NedelcuBogdanSebastian/SistemAchizitie/MODULE/AQETHBluePill_w_RESET/BLUEPILL-PINOUT.PNG

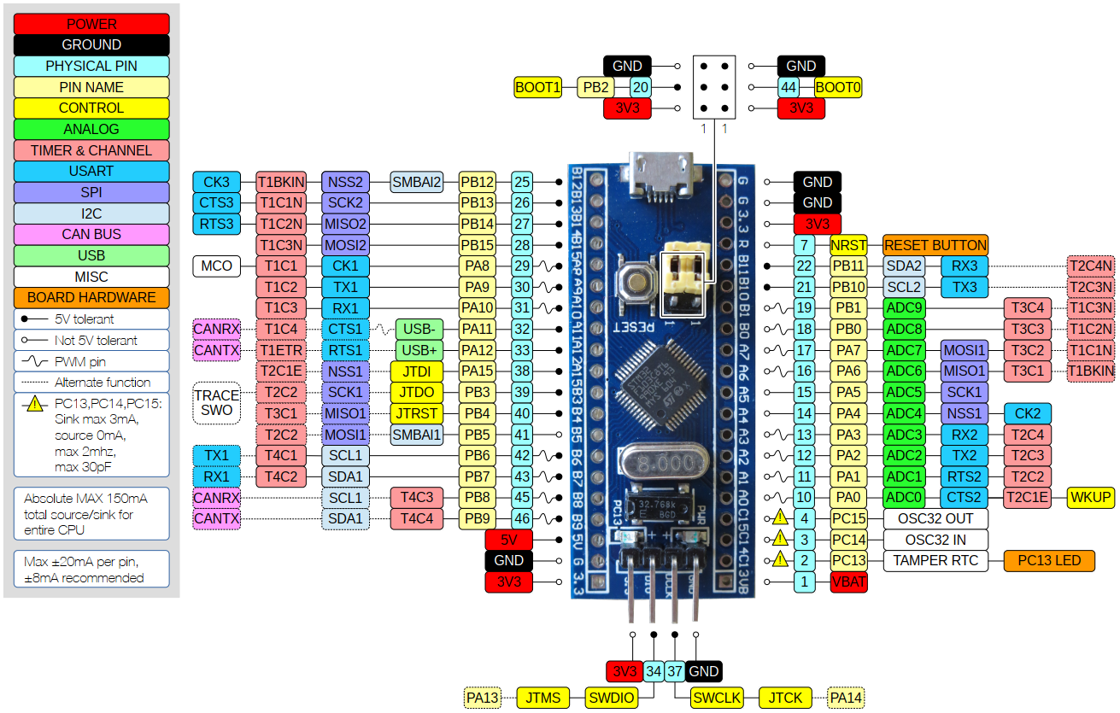
MODULE/AQETHBluePill_w_RESET/BLUEPILL-PINOUT.PNG
