NedelcuBogdanSebastian/SistemAchizitie/MODULE/PT100Module/CJMCU-MAX31865.bmp

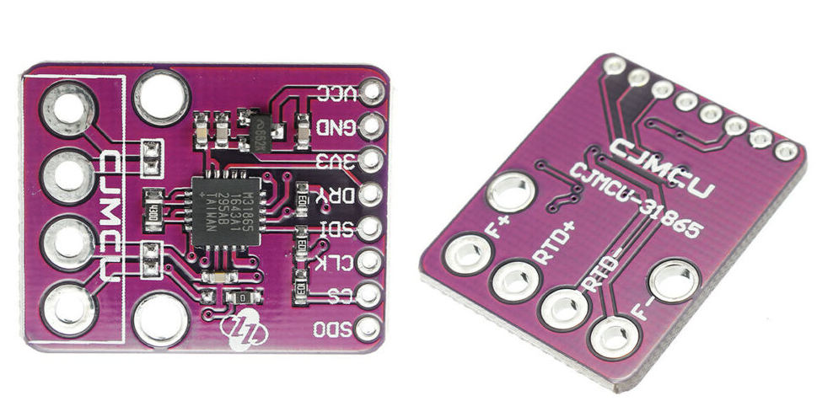
MODULE/PT100Module/CJMCU-MAX31865.bmp
