NedelcuBogdanSebastian/SistemAchizitie/MODULE/PT100Module/BOM-PCB-PT100.xlsx

 | DENUMIRE COMPONENTA | DESCRIERE COMPONENTA | COD ECAS
U3 | LM1117-MPX-3.3/NOPB | STABILIZATOR DE TENSIUNE; LDO, NEREGLABIL; 3,3V; 0,25A; SOT89-3 | MCP1703T-3302E/MB | 0.525
TERMINAL CU SURUB | 20.101M/2 | 9632670 WIRE-TO-BOARD TERMINAL BLOCK, 5 MM, 2 WAYS, 22 AWG, 12 AWG, SCREW | ARK210/2 | 0.150
LED | LED GREEN 0805 | LEN VERDE 0805 CARCASA ALBA | LTST-C170KGKT | 0.029
U4 | ATMEGA88PA-AU | AVR MICROCONTROLLER; EEPROM: 512B; SRAM: 1KB; FLASH: 8KB; TQFP32 | ATMEGA88PA-AU | 0.975
U1,U2,U5,U6 | MAX31865ATP+ | CONVERTOR DE TEMPERATURĂ; RTD; SMD; INTERFAŢĂ: SPI; TQFN20; 3,3V
C7,C9 | CL31A226MOCLNNC | CONDENSATOR: CERAMIC; 22UF; 16V; X5R; ±20%; SMD; 1206 SAMSUNG | CVUF022K12X-16 | 0.031
C1,C2,C3,C4,C5,C6,C8,C10,C11,C12,C13,C14,C15,C16 | C0805C104K5RAC | CONDENSATOR 0805, 100NF, 50V, XR7 +-10% | CVNF100K0805-100 | 0.029
R3,R4,R5,R7,R8,R9,R10 | SMD0805-10K-1% | REZISTENTA 10K
R6 | SMD0805-1K-1% | REZISTENTA 1K | CR0805K001-1 | 0.007
R1,R2,R10,R11 |  | REZISTENTA 430 OHM, 0.1%, 0805
DIO | DIODĂ: COMUTAŢIE; SMD; 100V; 200MA; 4NS; | 66 | PMLL4148L.115 | 0.015
IN DREAPTA | SOCLU; ŞIRURI PINI; MAMĂ; PIN:3; ÎN UNGHI 90°; 2,54MM; THT; 1X3 | 66 | ZL263-3SG | 0.023
IN STANGA | ŞIR PINI; ŞIRURI PINI; TATĂ; PIN:40; ÎN UNGHI 90°; 2,54MM; THT | 66 | ZL211-40KG | 0.090
