NedelcuBogdanSebastian/SistemAchizitie/MODULE/AdaptorK7EthernetTo485/AdaptorEthernet485.brd

## EAGLE design MODULE/AdaptorK7EthernetTo485/AdaptorEthernet485.brd (2024-10-08)

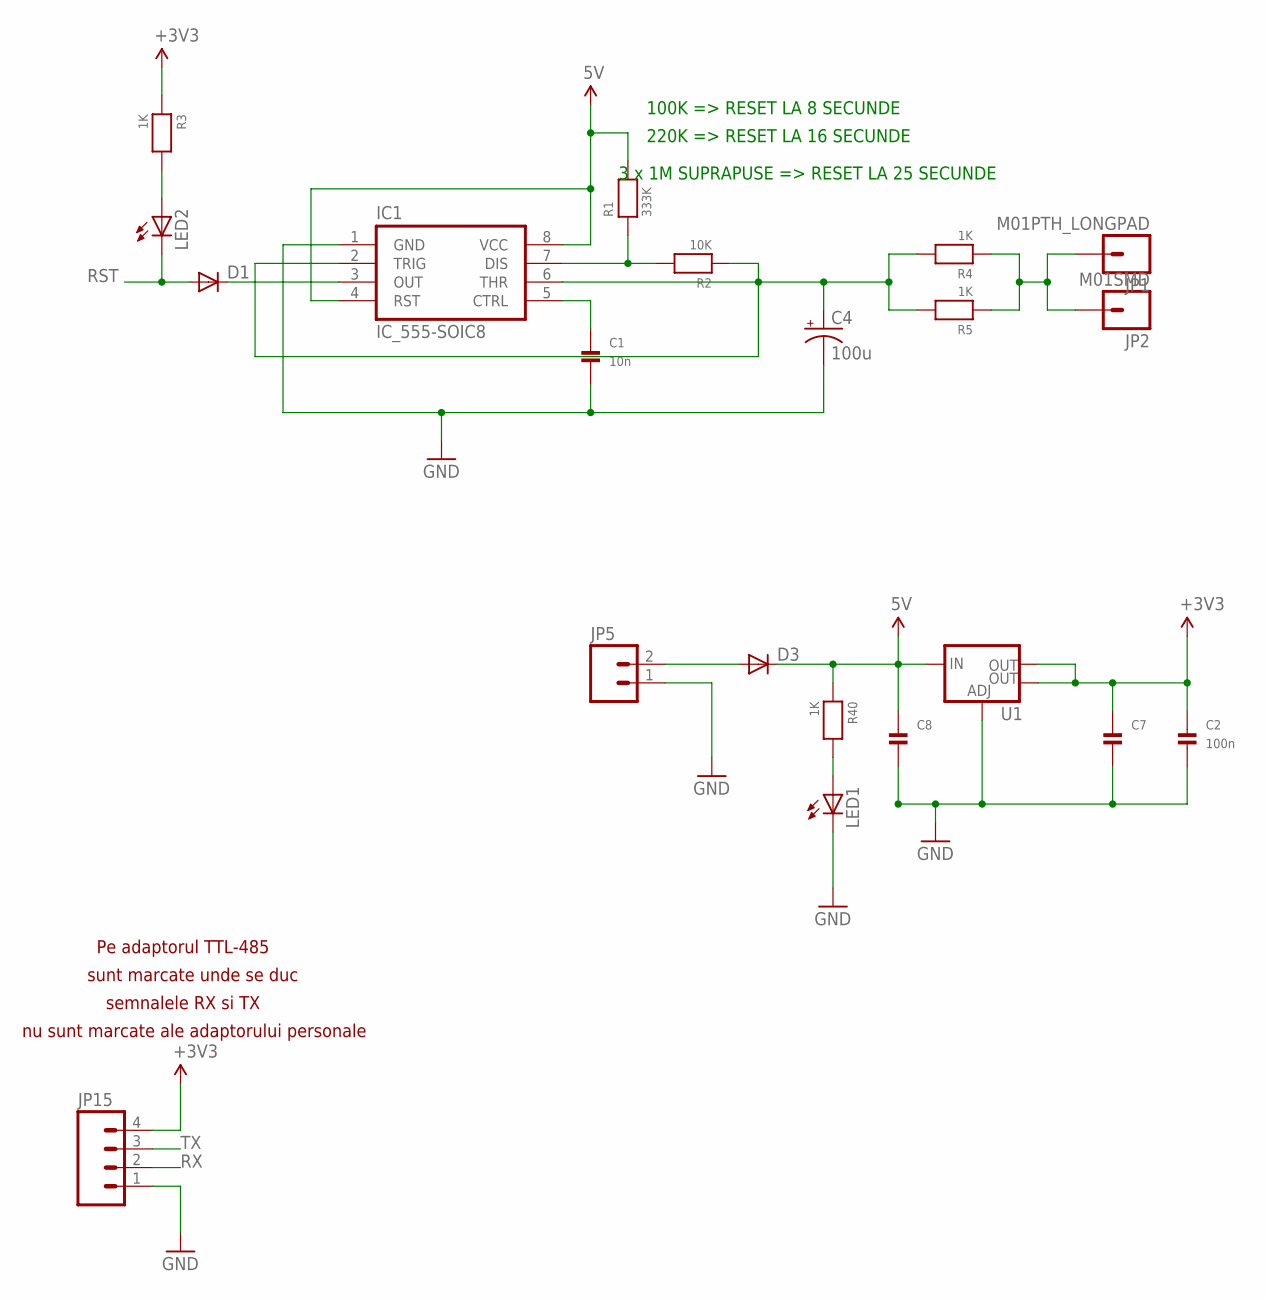
[picture p5: schematic AdaptorEthernet485.sch]

Parts:
C1: 10n; _0805MP
C2: 100n; _0805MP
C4: 100u; CPOL-RADIAL-10UF-25V
C7, C8: CAP_CERAMIC1206; 1206
D1, D3: DIODE-DO214AA; DO214AA
IC1: IC_555-SOIC8; SOIC-8
JP1: M01PTH_LONGPAD; 1X01_LONGPAD
JP2: M01SMD; LUXEON-PAD
JP5: M02PTH4; 1X02_XTRA_BIG
JP15: M04LONGPADS; 1X04_LONGPADS
LED1, LED2: LED-3MM-NO_SILK; LED3MM-NS
R1: 333K; _0805MP
R2: 10K; _0805MP
R3, R4, R5, R40: 1K; _0805MP
U1: V_REG_LM1117SOT223; SOT223

Connections:
5V: C8.1, D3.C, IC1.4 (RST), IC1.8 (VCC), R1.2, R40.1, U1.3 (IN)
CTRL: C1.1, IC1.5 (CTRL)
GND: C1.2, C2.2, C4.2 (-), C7.2, C8.2, IC1.1 (GND), JP5.1, JP15.1, LED1.K (C), U1.1 (ADJ)
unnamed: D3.A, JP5.2
unnamed: LED2.A, R3.2
unnamed: C4.1 (+), IC1.2 (TRIG), IC1.6 (THR), R2.1, R4.2, R5.2
unnamed: D1.C, IC1.3 (OUT)
unnamed: IC1.7 (DIS), R1.1, R2.2
unnamed: JP1.1, JP2.P$1, R4.1, R5.1
unnamed: LED1.A, R40.2
RST: D1.A, LED2.K (C)
RX: JP15.2
TX: JP15.3
VCC: C2.1, C7.1, JP15.4, R3.1, U1.2 (OUT), U1.4 (OUT)

Notes on the sheet:
Pe adaptorul TTL-485
sunt marcate unde se duc
semnalele RX si TX
nu sunt marcate ale adaptorului personale
3 x 1M SUPRAPUSE => RESET LA 25 SECUNDE
220K => RESET LA 16 SECUNDE
100K => RESET LA 8 SECUNDE

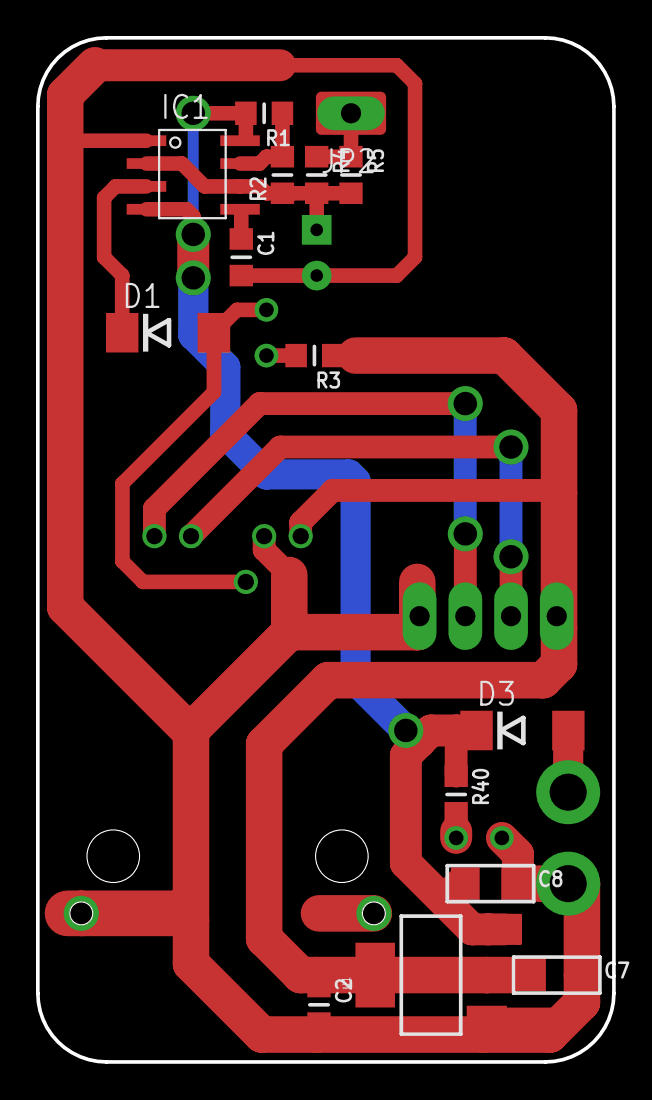
[picture p6: board AdaptorEthernet485.brd from above]

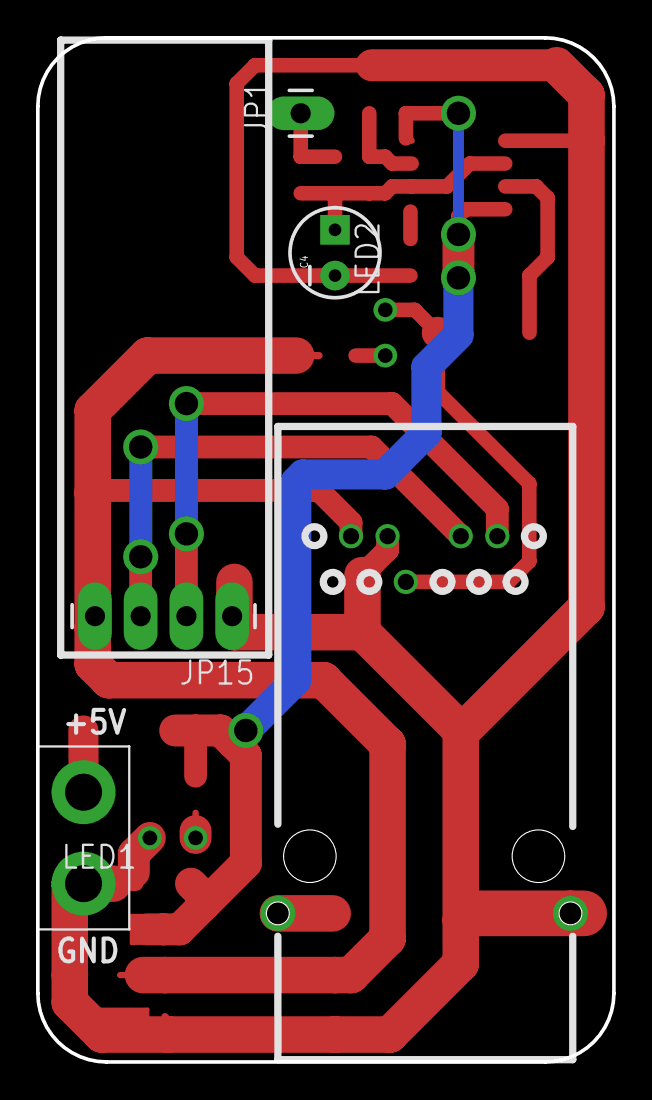
[picture p7: board AdaptorEthernet485.brd from below]

Board: 2 copper layers, 32.0 x 56.9 mm, 21 parts (6 on the bottom side), 12 nets.
