NedelcuBogdanSebastian/SistemAchizitie/MODULE/DigitalModule/DIGITAL2.brd

## EAGLE design MODULE/DigitalModule/DIGITAL2.brd (2024-10-08)

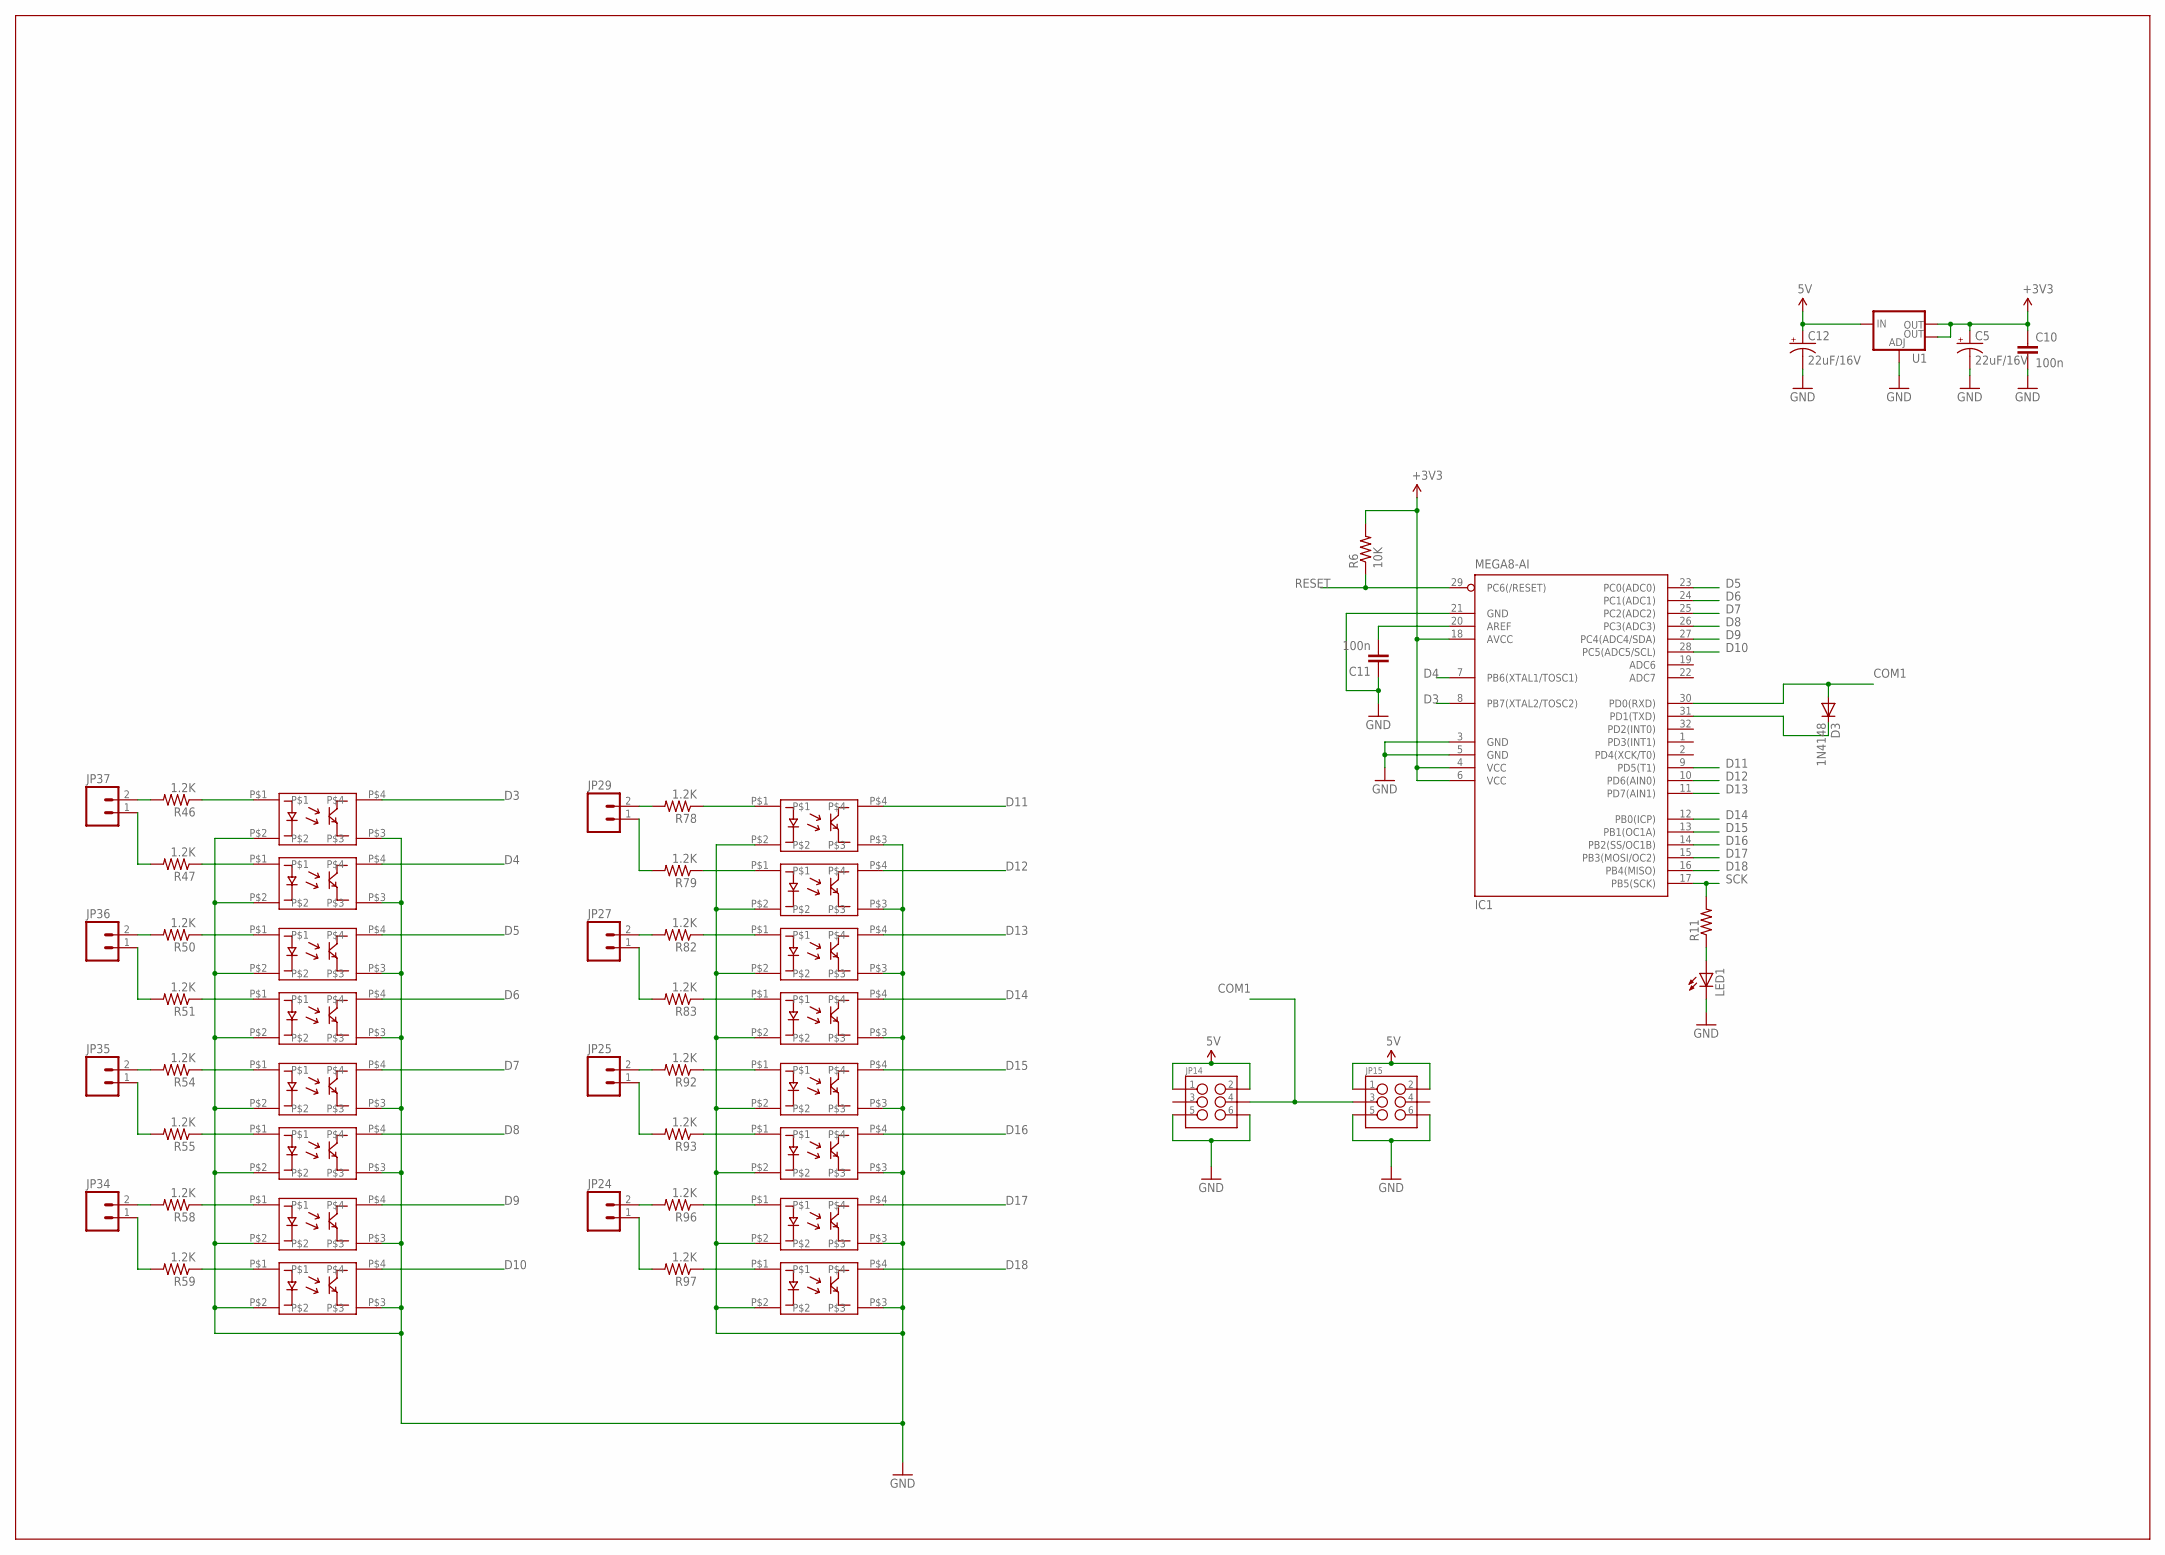
[picture p8: schematic DIGITAL2.sch]

Parts:
C5, C12: 22uF/16V; EIA3216
C10, C11: 100n; 0805
D3: 1N4148; MINIMELF
IC1: MEGA8-AI; TQFP32-08
JP14, JP15: M03X22X3_SILK_MALE_PTH; 2X3
JP24, JP25, JP27, JP29, JP34, JP35, JP36, JP37: M025MM; SCREWTERMINAL-5MM-2
LED1: LEDCHIP-LED0805; CHIP-LED0805
R6: 10K; 0805
R11: RESISTOR0805-RES; 0805
R46, R47, R50, R51, R54, R55, R58, R59, R78, R79, R82, R83, R92, R93, R96, R97: 1.2K; 1206
U1: V_REG_LM1117SOT223; SOT223
U$13, U$14, U$15, U$16, U$17, U$18, U$19, U$20, U$29, U$30, U$31, U$32, U$33, U$34, U$35, U$36: IS181D-I; TLP181-I

Connections:
5V: C12.A (+), JP14.1, JP14.2, JP15.1, JP15.2, U1.3 (IN)
COM1: D3.A, IC1.30 (PD0(RXD)), JP14.4, JP15.3
D3: IC1.8 (PB7(XTAL2/TOSC2)), U$13.P$4
D4: IC1.7 (PB6(XTAL1/TOSC1)), U$14.P$4
D5: IC1.23 (PC0(ADC0)), U$15.P$4
D6: IC1.24 (PC1(ADC1)), U$16.P$4
D7: IC1.25 (PC2(ADC2)), U$17.P$4
D8: IC1.26 (PC3(ADC3)), U$18.P$4
D9: IC1.27 (PC4(ADC4/SDA)), U$19.P$4
D10: IC1.28 (PC5(ADC5/SCL)), U$20.P$4
D11: IC1.9 (PD5(T1)), U$29.P$4
D12: IC1.10 (PD6(AIN0)), U$30.P$4
D13: IC1.11 (PD7(AIN1)), U$31.P$4
D14: IC1.12 (PB0(ICP)), U$32.P$4
D15: IC1.13 (PB1(OC1A)), U$33.P$4
D16: IC1.14 (PB2(SS/OC1B)), U$34.P$4
D17: IC1.15 (PB3(MOSI/OC2)), U$35.P$4
D18: IC1.16 (PB4(MISO)), U$36.P$4
GND: C5.C (-), C10.2, C11.1, C12.C (-), IC1.3 (GND), IC1.5 (GND), IC1.21 (GND), JP14.5, JP14.6, JP15.5, JP15.6, LED1.C, U1.1 (ADJ), U$13.P$2, U$13.P$3, U$14.P$2, U$14.P$3, U$15.P$2, U$15.P$3, U$16.P$2, U$16.P$3, U$17.P$2, U$17.P$3, U$18.P$2, U$18.P$3, U$19.P$2, U$19.P$3, U$20.P$2, U$20.P$3, U$29.P$2, U$29.P$3, U$30.P$2, U$30.P$3, U$31.P$2, U$31.P$3, U$32.P$2, U$32.P$3, U$33.P$2, U$33.P$3, U$34.P$2, U$34.P$3, U$35.P$2, U$35.P$3, U$36.P$2, U$36.P$3
unnamed: LED1.A, R11.1
unnamed: D3.C, IC1.31 (PD1(TXD))
unnamed: JP29.2, R78.2
unnamed: C11.2, IC1.20 (AREF)
unnamed: JP27.2, R82.2
unnamed: JP25.2, R92.2
unnamed: JP24.2, R96.2
unnamed: JP27.1, R83.2
unnamed: JP25.1, R93.2
unnamed: JP24.1, R97.2
unnamed: JP37.2, R46.2
unnamed: JP37.1, R47.2
unnamed: R46.1, U$13.P$1
unnamed: R47.1, U$14.P$1
unnamed: JP36.2, R50.2
unnamed: JP36.1, R51.2
unnamed: R50.1, U$15.P$1
unnamed: R51.1, U$16.P$1
unnamed: JP35.2, R54.2
unnamed: JP35.1, R55.2
unnamed: R54.1, U$17.P$1
unnamed: R55.1, U$18.P$1
unnamed: JP34.2, R58.2
unnamed: JP34.1, R59.2
unnamed: R58.1, U$19.P$1
unnamed: R59.1, U$20.P$1
unnamed: JP29.1, R79.2
unnamed: R78.1, U$29.P$1
unnamed: R79.1, U$30.P$1
unnamed: R82.1, U$31.P$1
unnamed: R83.1, U$32.P$1
unnamed: R92.1, U$33.P$1
unnamed: R93.1, U$34.P$1
unnamed: R96.1, U$35.P$1
unnamed: R97.1, U$36.P$1
RESET: IC1.29 (PC6(/RESET)), R6.1
SCK: IC1.17 (PB5(SCK)), R11.2
VCC: C5.A (+), C10.1, IC1.4 (VCC), IC1.6 (VCC), IC1.18 (AVCC), R6.2, U1.2 (OUT), U1.4 (OUT)

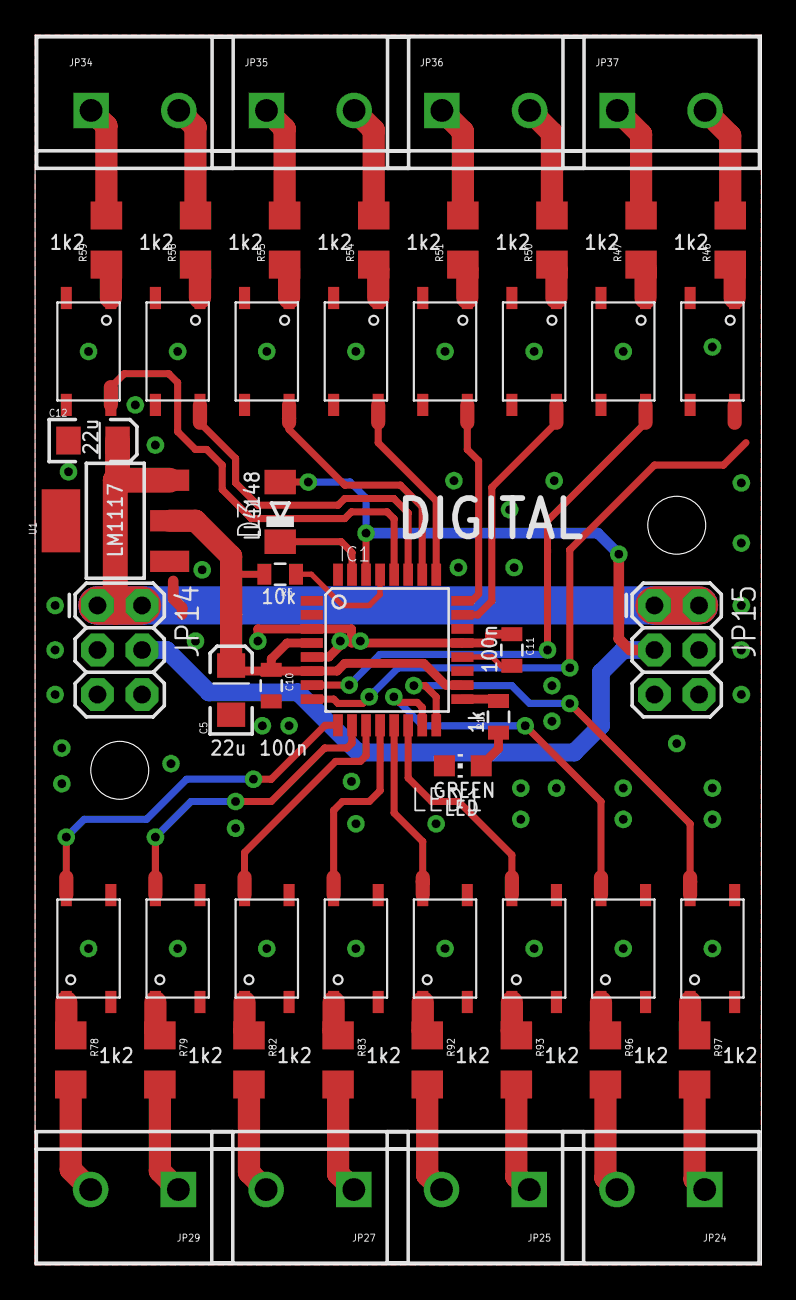
[picture p9: board DIGITAL2.brd from above]

Board: 2 copper layers, 41.4 x 70.1 mm, 54 parts (0 on the bottom side), 57 nets.

Other parts of the board:
STANDOFF1, STANDOFF3: STAND-OFF
