NedelcuBogdanSebastian/SistemAchizitie/MODULE/PT100Module/PT100RTD.brd

## EAGLE design MODULE/PT100Module/PT100RTD.brd (2024-10-08)

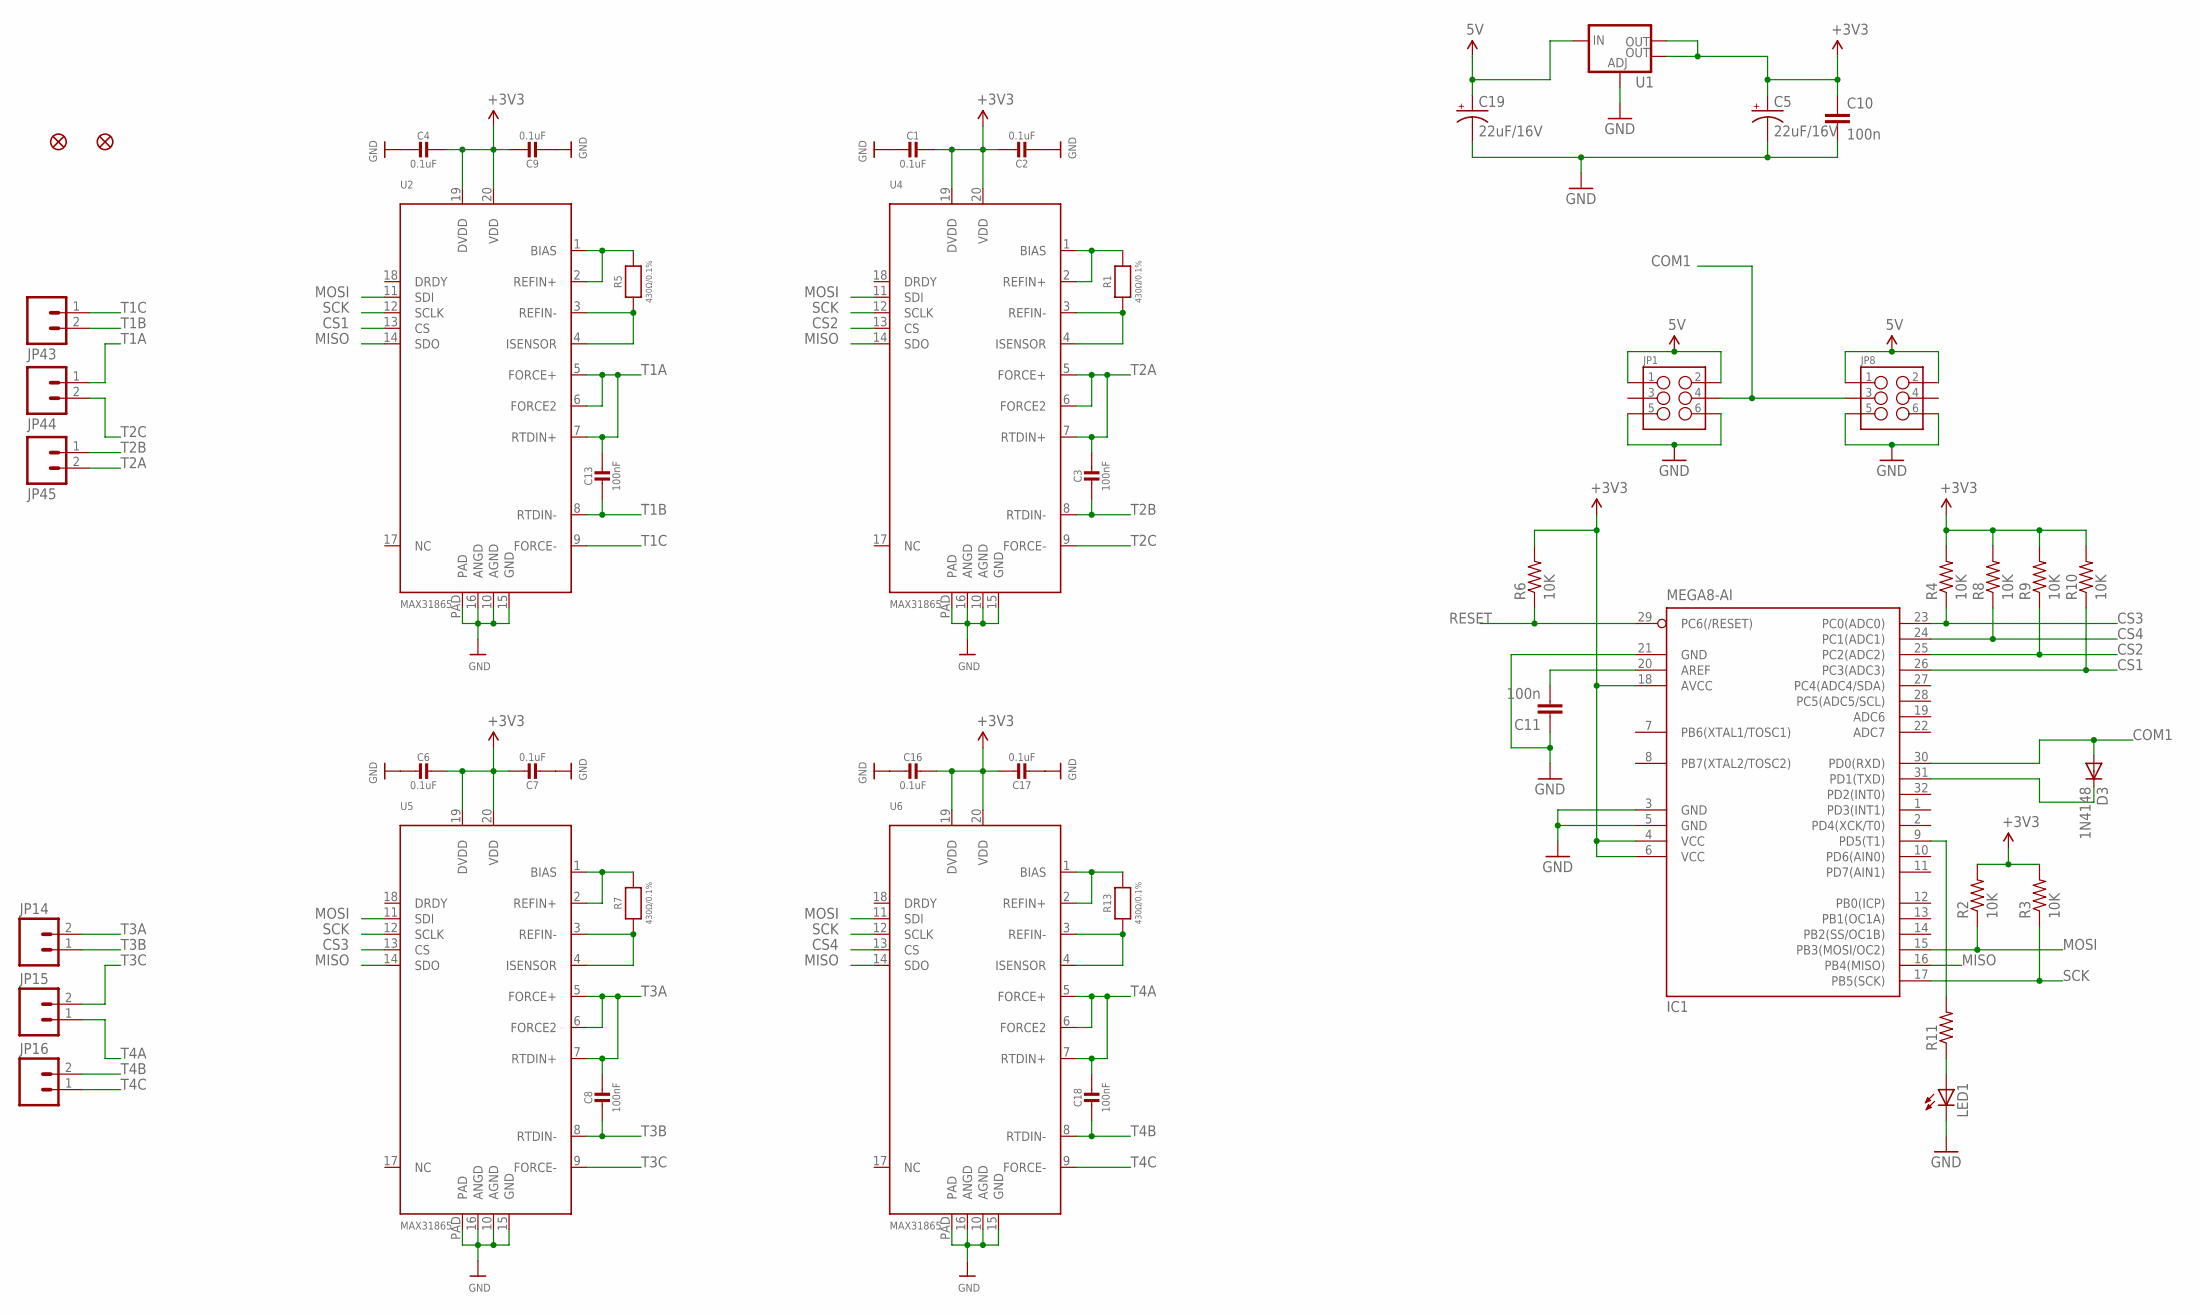
[picture p10: schematic PT100RTD.sch]

Parts:
C1, C2, C4, C6, C7, C9, C16, C17: 0.1uF; 0805-NO
C3, C8, C13, C18: 100nF; 0805-NO
C5, C19: 22uF/16V; EIA3216
C10, C11: 100n; 0805
D3: 1N4148; MINIMELF
FD1, FD2: FIDUCIALUFIDUCIAL; FIDUCIAL-MICRO
IC1: MEGA8-AI; TQFP32-08
JP1, JP8: M03X22X3_SILK_MALE_PTH; 2X3
JP14, JP15, JP16, JP43, JP44, JP45: M025MM; SCREWTERMINAL-5MM-2
LED1: LEDCHIP-LED0805; CHIP-LED0805
R1, R5, R7, R13: 430Ω/0.1%; 0805-NO
R2, R3, R4, R6, R8, R9, R10: 10K; 0805
R11: RESISTOR0805-RES; 0805
U1: V_REG_LM1117SOT223; SOT223
U2, U4, U5, U6: MAX31865; QFN20_4MM_0.65MM

Connections:
5V: C19.A (+), JP1.1, JP1.2, JP8.1, JP8.2, U1.3 (IN)
COM1: D3.A, IC1.30 (PD0(RXD)), JP1.4, JP8.3
CS1: IC1.26 (PC3(ADC3)), R10.1, U2.13 (CS)
CS2: IC1.25 (PC2(ADC2)), R9.1, U4.13 (CS)
CS3: IC1.23 (PC0(ADC0)), R4.1, U5.13 (CS)
CS4: IC1.24 (PC1(ADC1)), R8.1, U6.13 (CS)
GND: C1.2, C2.2, C4.2, C5.C (-), C6.2, C7.2, C9.2, C10.2, C11.1, C16.2, C17.2, C19.C (-), IC1.3 (GND), IC1.5 (GND), IC1.21 (GND), JP1.5, JP1.6, JP8.5, JP8.6, LED1.C, U1.1 (ADJ), U2.10 (AGND), U2.15 (GND), U2.16 (ANGD), U2.PAD, U4.10 (AGND), U4.15 (GND), U4.16 (ANGD), U4.PAD, U5.10 (AGND), U5.15 (GND), U5.16 (ANGD), U5.PAD, U6.10 (AGND), U6.15 (GND), U6.16 (ANGD), U6.PAD
MISO: IC1.16 (PB4(MISO)), U2.14 (SDO), U4.14 (SDO), U5.14 (SDO), U6.14 (SDO)
MOSI: IC1.15 (PB3(MOSI/OC2)), R2.1, U2.11 (SDI), U4.11 (SDI), U5.11 (SDI), U6.11 (SDI)
unnamed: LED1.A, R11.1
unnamed: D3.C, IC1.31 (PD1(TXD))
unnamed: R5.2, U2.1 (BIAS), U2.2 (REFIN+)
unnamed: R5.1, U2.3 (REFIN-), U2.4 (ISENSOR)
unnamed: C11.2, IC1.20 (AREF)
unnamed: R1.2, U4.1 (BIAS), U4.2 (REFIN+)
unnamed: R1.1, U4.3 (REFIN-), U4.4 (ISENSOR)
unnamed: R7.2, U5.1 (BIAS), U5.2 (REFIN+)
unnamed: R7.1, U5.3 (REFIN-), U5.4 (ISENSOR)
unnamed: IC1.9 (PD5(T1)), R11.2
unnamed: R13.2, U6.1 (BIAS), U6.2 (REFIN+)
unnamed: R13.1, U6.3 (REFIN-), U6.4 (ISENSOR)
RESET: IC1.29 (PC6(/RESET)), R6.1
SCK: IC1.17 (PB5(SCK)), R3.1, U2.12 (SCLK), U4.12 (SCLK), U5.12 (SCLK), U6.12 (SCLK)
T1A: C13.1, JP44.1, U2.5 (FORCE+), U2.6 (FORCE2), U2.7 (RTDIN+)
T1B: C13.2, JP43.2, U2.8 (RTDIN-)
T1C: JP43.1, U2.9 (FORCE-)
T2A: C3.1, JP45.2, U4.5 (FORCE+), U4.6 (FORCE2), U4.7 (RTDIN+)
T2B: C3.2, JP45.1, U4.8 (RTDIN-)
T2C: JP44.2, U4.9 (FORCE-)
T3A: C8.1, JP14.2, U5.5 (FORCE+), U5.6 (FORCE2), U5.7 (RTDIN+)
T3B: C8.2, JP14.1, U5.8 (RTDIN-)
T3C: JP15.2, U5.9 (FORCE-)
T4A: C18.1, JP15.1, U6.5 (FORCE+), U6.6 (FORCE2), U6.7 (RTDIN+)
T4B: C18.2, JP16.2, U6.8 (RTDIN-)
T4C: JP16.1, U6.9 (FORCE-)
VCC: C1.1, C2.1, C4.1, C5.A (+), C6.1, C7.1, C9.1, C10.1, C16.1, C17.1, IC1.4 (VCC), IC1.6 (VCC), IC1.18 (AVCC), R2.2, R3.2, R4.2, R6.2, R8.2, R9.2, R10.2, U1.2 (OUT), U1.4 (OUT), U2.19 (DVDD), U2.20 (VDD), U4.19 (DVDD), U4.20 (VDD), U5.19 (DVDD), U5.20 (VDD), U6.19 (DVDD), U6.20 (VDD)

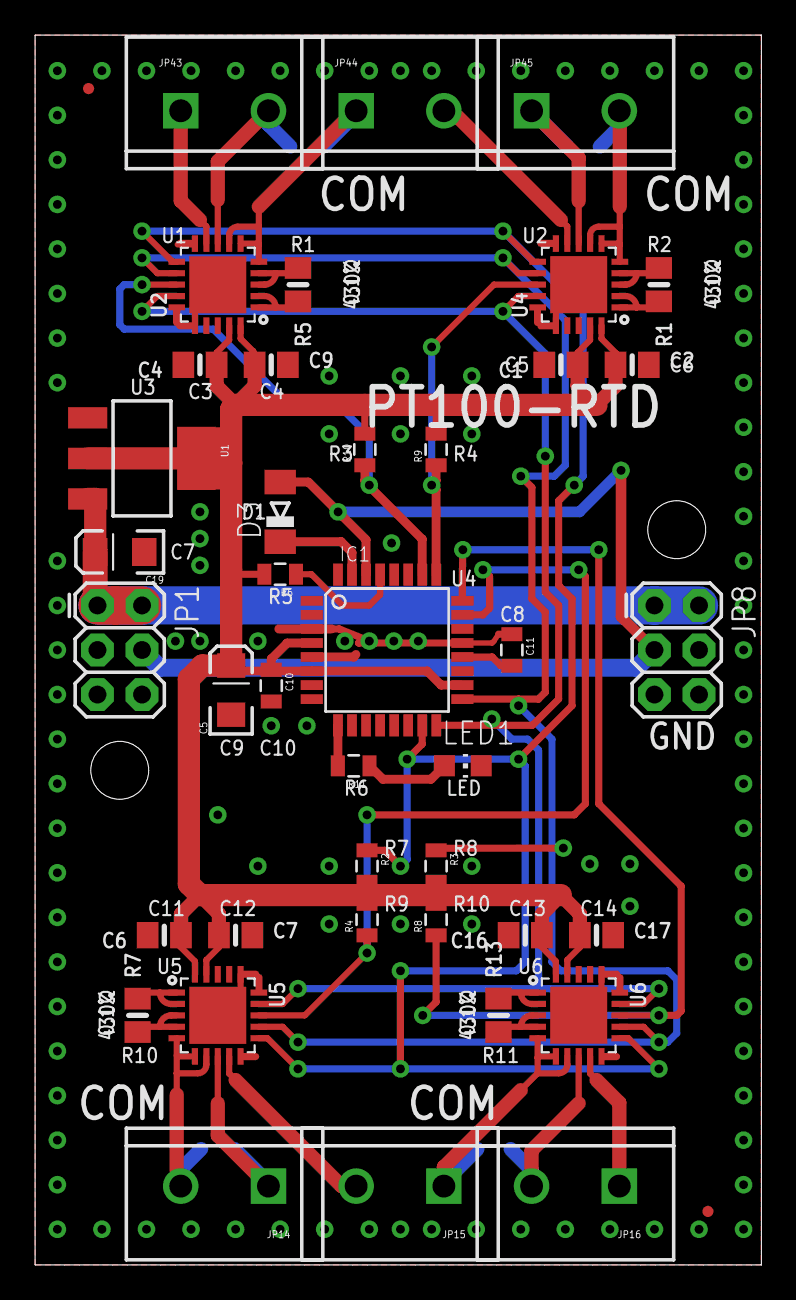
[picture p11: board PT100RTD.brd from above]

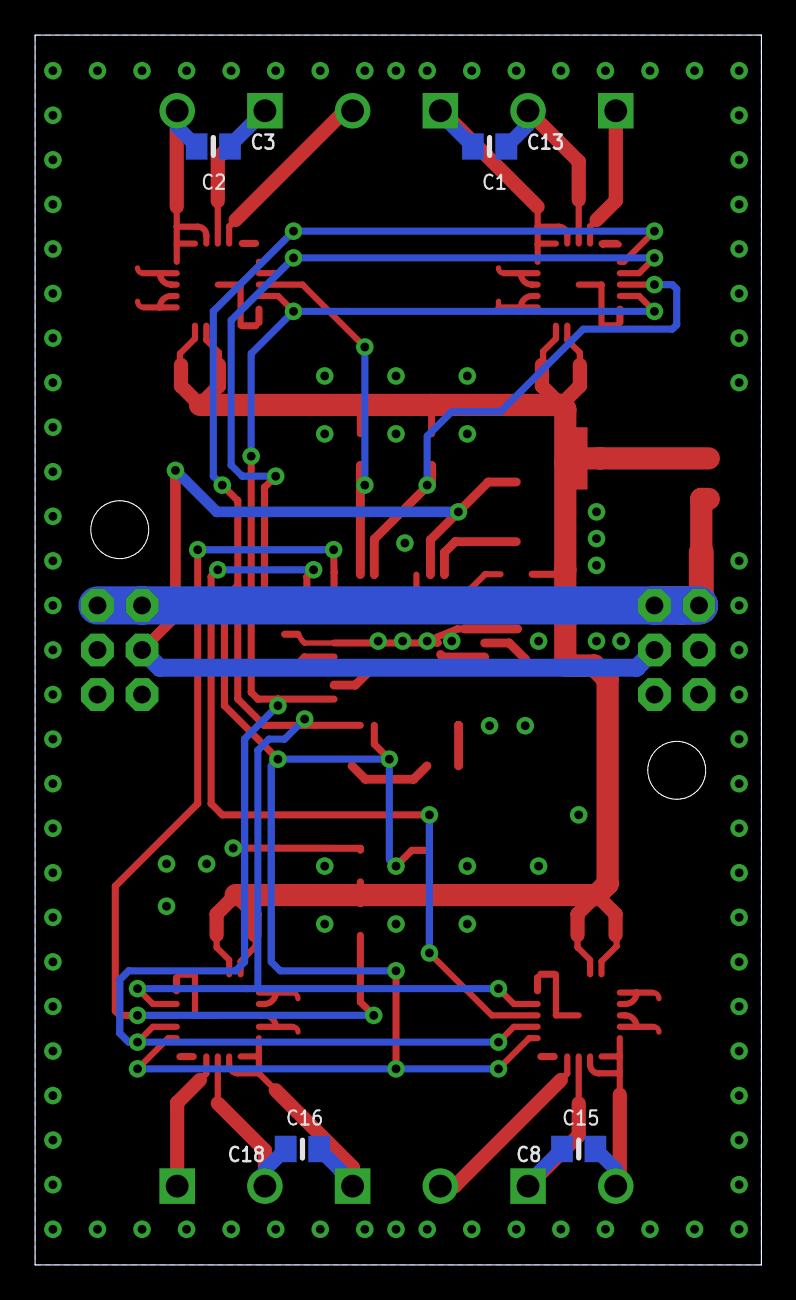
[picture p12: board PT100RTD.brd from below]

Board: 2 copper layers, 41.4 x 70.1 mm, 48 parts (4 on the bottom side), 36 nets.

Other parts of the board:
STANDOFF2, STANDOFF3: STAND-OFF
