NedelcuBogdanSebastian/SistemAchizitie/MODULE/4-20mAModule/4-20mA.brd

## EAGLE design MODULE/4-20mAModule/4-20mA.brd (2024-10-08)

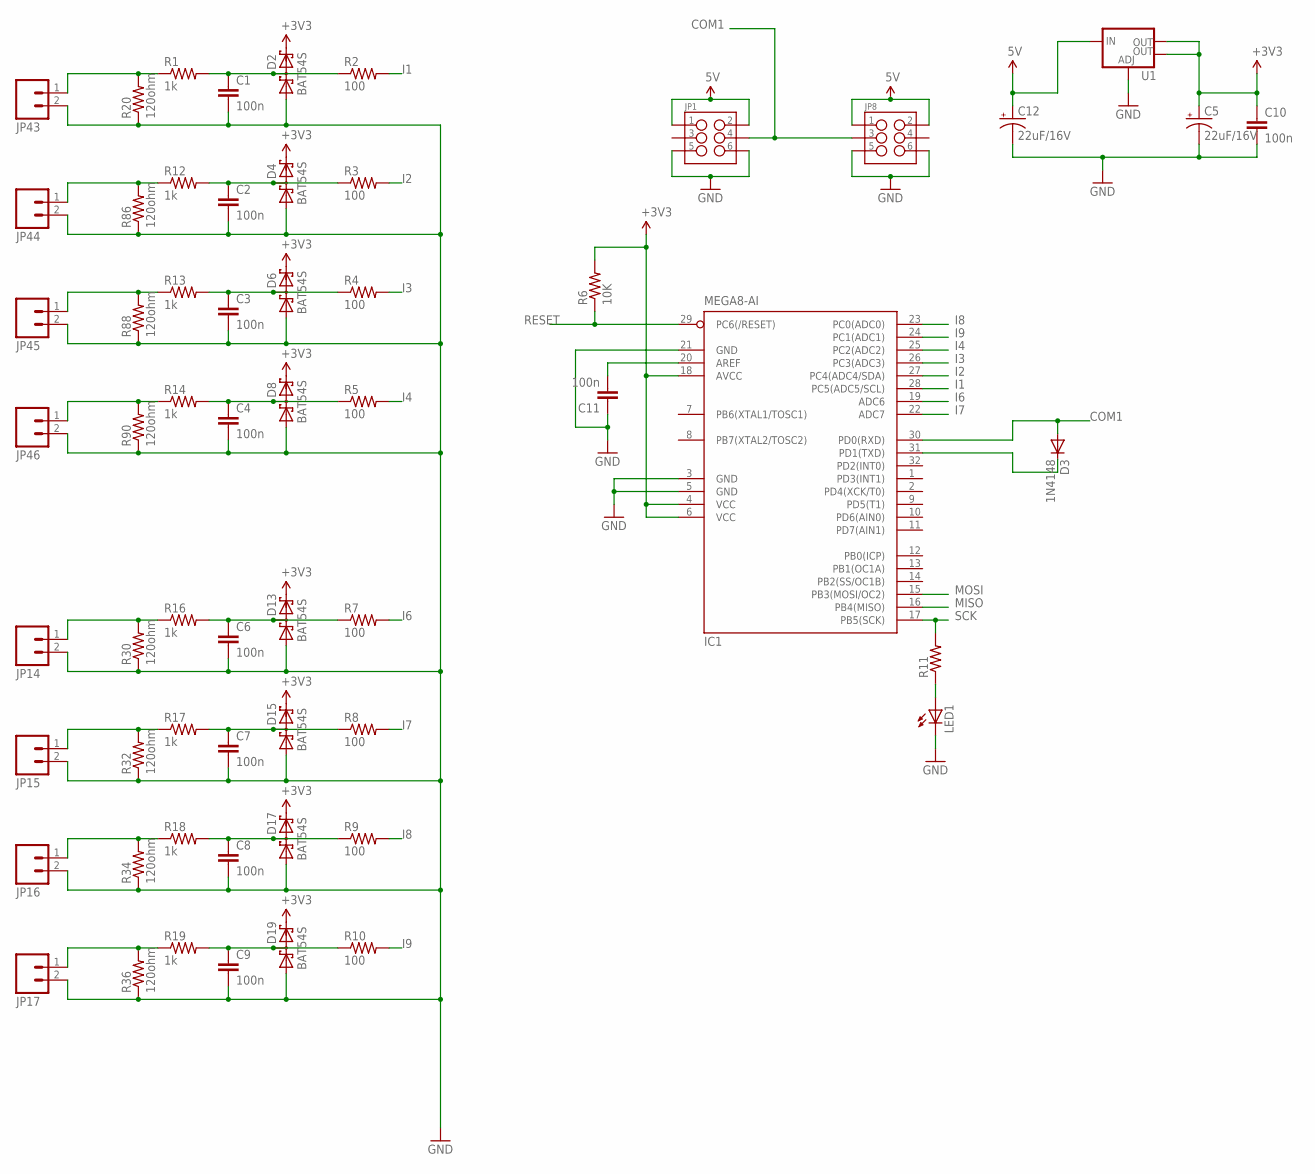
[picture p13: schematic 4-20mA.sch]

Parts:
C1, C2, C3, C4, C6, C7, C8, C9, C10, C11: 100n; 0805
C5, C12: 22uF/16V; EIA3216
D2, D4, D6, D8, D13, D15, D17, D19: BAT54S; SOT23
D3: 1N4148; MINIMELF
IC1: MEGA8-AI; TQFP32-08
JP1, JP8: M03X22X3_SILK_MALE_PTH; 2X3
JP14, JP15, JP16, JP17, JP43, JP44, JP45, JP46: M025MM; SCREWTERMINAL-5MM-2
LED1: LEDCHIP-LED0805; CHIP-LED0805
R1, R12, R13, R14, R16, R17, R18, R19: 1k; 0805
R2, R3, R4, R5, R7, R8, R9, R10: 100; 0805
R6: 10K; 0805
R11: RESISTOR0805-RES; 0805
R20, R30, R32, R34, R36, R86, R88, R90: 120ohm; R2010
U1: V_REG_LM1117SOT223; SOT223

Connections:
5V: C12.A (+), JP1.1, JP1.2, JP8.1, JP8.2, U1.3 (IN)
COM1: D3.A, IC1.30 (PD0(RXD)), JP1.4, JP8.3
GND: C1.2, C2.2, C3.2, C4.2, C5.C (-), C6.2, C7.2, C8.2, C9.2, C10.2, C11.1, C12.C (-), D2.1 (A1), D4.1 (A1), D6.1 (A1), D8.1 (A1), D13.1 (A1), D15.1 (A1), D17.1 (A1), D19.1 (A1), IC1.3 (GND), IC1.5 (GND), IC1.21 (GND), JP1.5, JP1.6, JP8.5, JP8.6, JP14.2, JP15.2, JP16.2, JP17.2, JP43.2, JP44.2, JP45.2, JP46.2, LED1.C, R20.1, R30.1, R32.1, R34.1, R36.1, R86.1, R88.1, R90.1, U1.1 (ADJ)
I1: IC1.28 (PC5(ADC5/SCL)), R2.2
I2: IC1.27 (PC4(ADC4/SDA)), R3.2
I3: IC1.26 (PC3(ADC3)), R4.2
I4: IC1.25 (PC2(ADC2)), R5.2
I6: IC1.19 (ADC6), R7.2
I7: IC1.22 (ADC7), R8.2
I8: IC1.23 (PC0(ADC0)), R9.2
I9: IC1.24 (PC1(ADC1)), R10.2
MISO: IC1.16 (PB4(MISO))
MOSI: IC1.15 (PB3(MOSI/OC2))
unnamed: LED1.A, R11.1
unnamed: D3.C, IC1.31 (PD1(TXD))
unnamed: C11.2, IC1.20 (AREF)
unnamed: C9.1, D19.3 (C1A2), R10.1, R19.2
unnamed: C8.1, D17.3 (C1A2), R9.1, R18.2
unnamed: C7.1, D15.3 (C1A2), R8.1, R17.2
unnamed: C6.1, D13.3 (C1A2), R7.1, R16.2
unnamed: C4.1, D8.3 (C1A2), R5.1, R14.2
unnamed: C3.1, D6.3 (C1A2), R4.1, R13.2
unnamed: C2.1, D4.3 (C1A2), R3.1, R12.2
unnamed: C1.1, D2.3 (C1A2), R1.2, R2.1
unnamed: JP43.1, R1.1, R20.2
unnamed: JP14.1, R16.1, R30.2
unnamed: JP44.1, R12.1, R86.2
unnamed: JP45.1, R13.1, R88.2
unnamed: JP46.1, R14.1, R90.2
unnamed: JP15.1, R17.1, R32.2
unnamed: JP16.1, R18.1, R34.2
unnamed: JP17.1, R19.1, R36.2
RESET: IC1.29 (PC6(/RESET)), R6.1
SCK: IC1.17 (PB5(SCK)), R11.2
VCC: C5.A (+), C10.1, D2.2 (C2), D4.2 (C2), D6.2 (C2), D8.2 (C2), D13.2 (C2), D15.2 (C2), D17.2 (C2), D19.2 (C2), IC1.4 (VCC), IC1.6 (VCC), IC1.18 (AVCC), R6.2, U1.2 (OUT), U1.4 (OUT)

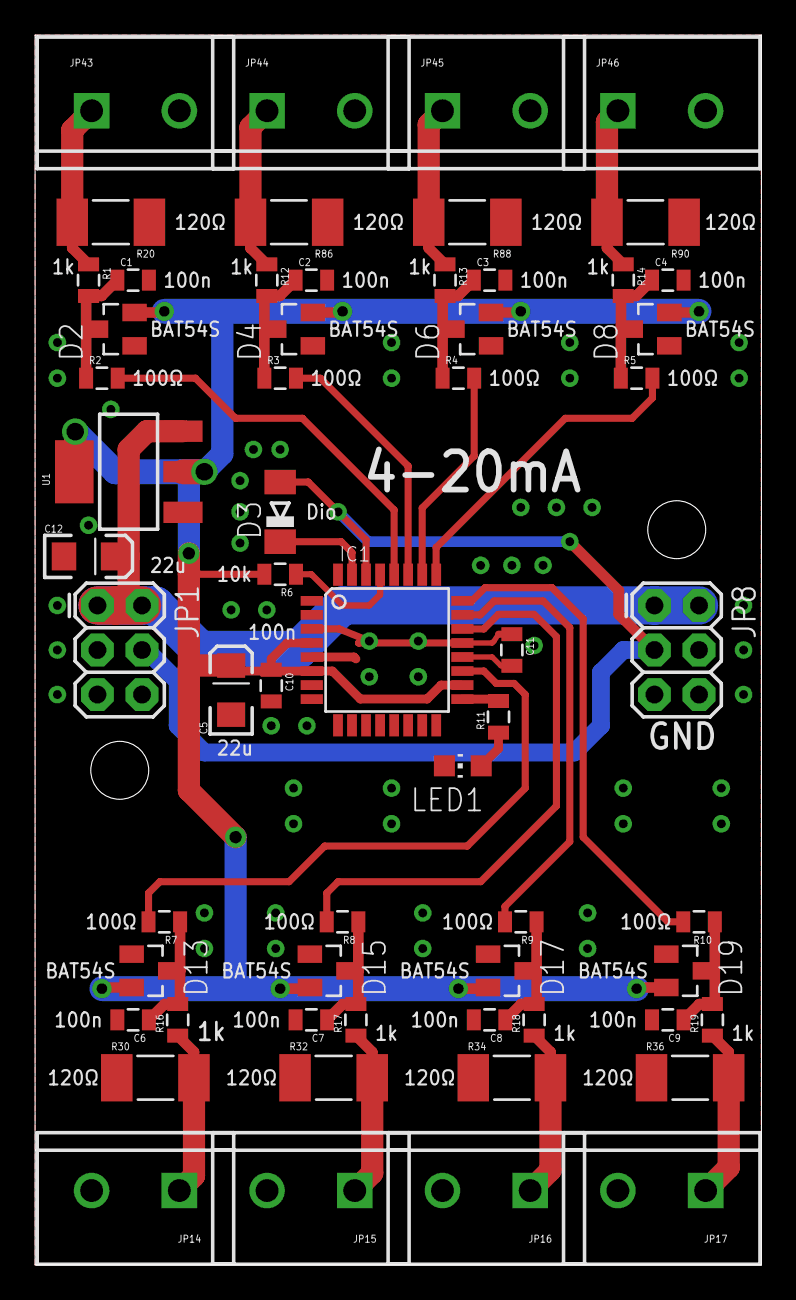
[picture p14: board 4-20mA.brd from above]

Board: 2 copper layers, 41.4 x 70.1 mm, 62 parts (0 on the bottom side), 33 nets.

Other parts of the board:
STANDOFF2, STANDOFF3: STAND-OFF
