NedelcuBogdanSebastian/SistemAchizitie/MODULE/AQETHBluePill_w_RESET/Adaptor485mini.BRD

## EAGLE design MODULE/AQETHBluePill_w_RESET/Adaptor485mini.BRD (2024-10-08)

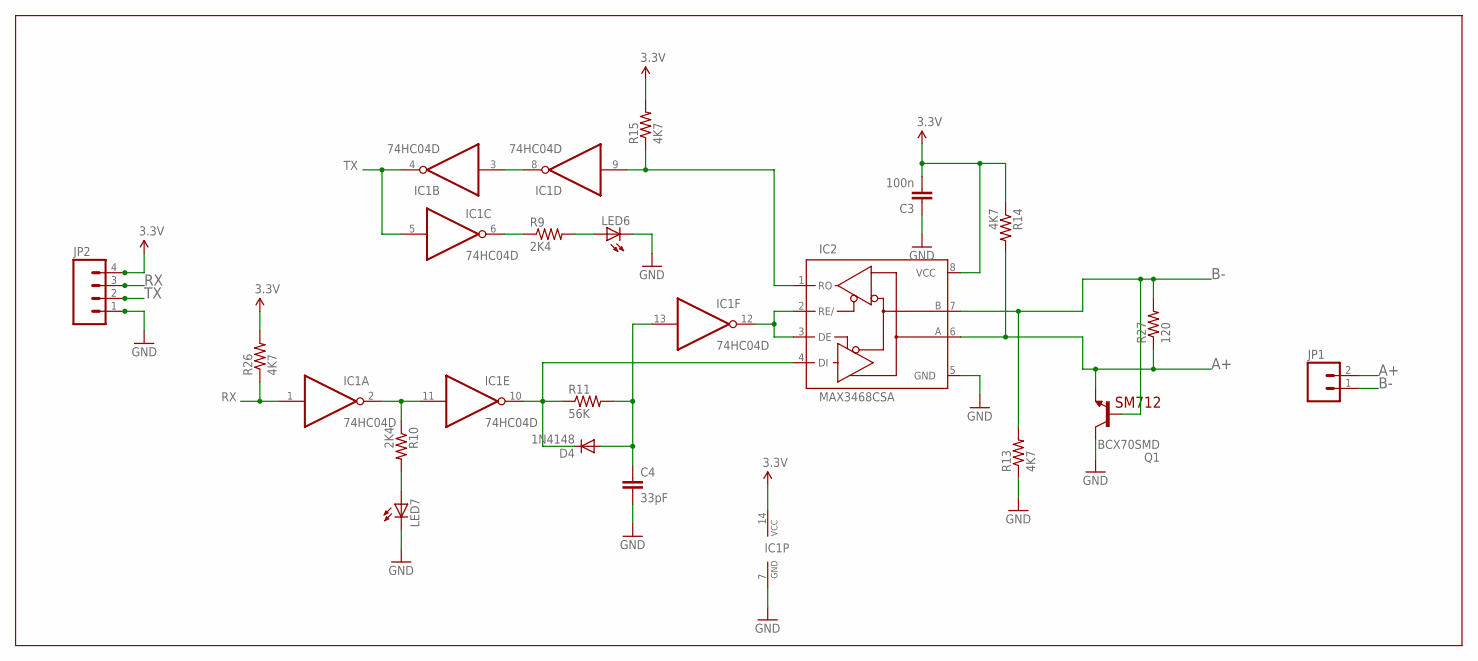
[picture p15: schematic Adaptor485mini.sch]

Parts:
C3: 100n; 0805
C4: 33pF; 0805
D4: 1N4148; MINIMELF
IC1: 74HC04D; SO14
IC2: MAX3468CSA; SO08
JP1: M02PTH; 1X02
JP2: M04PTH; 1X04
LED6, LED7: LEDCHIP-LED0805; CHIP-LED0805
Q1: BCX70SMD; SOT23
R9, R10: 2K4; 0805
R11: 56K; 0805
R13, R14, R15, R26: 4K7; 0805
R27: 120; 0805

Connections:
3.3V: C3.2, IC1.14 (VCC), IC2.8 (VCC), JP2.4, R14.1, R15.2, R26.2
A+: IC2.6 (A), JP1.2, Q1.2 (E), R14.2, R27.1
B-: IC2.7 (B), JP1.1, Q1.1 (B), R13.2, R27.2
GND: C3.1, C4.2, IC1.7 (GND), IC2.5 (GND), JP2.1, LED6.C, LED7.C, Q1.3 (C), R13.1
unnamed: LED7.A, R10.2
unnamed: LED6.A, R9.2
unnamed: IC1.2 (O), IC1.11 (I), R10.1
unnamed: IC1.9 (I), IC2.1 (RO), R15.1
unnamed: IC1.3 (I), IC1.8 (O)
unnamed: C4.1, D4.A, IC1.13 (I), R11.2
unnamed: IC1.6 (O), R9.1
unnamed: D4.C, IC1.10 (O), IC2.4 (DI), R11.1
unnamed: IC1.12 (O), IC2.2 (RE/), IC2.3 (DE)
RX: IC1.1 (I), JP2.3, R26.1
TX: IC1.4 (O), IC1.5 (I), JP2.2

Notes on the sheet:
SM712

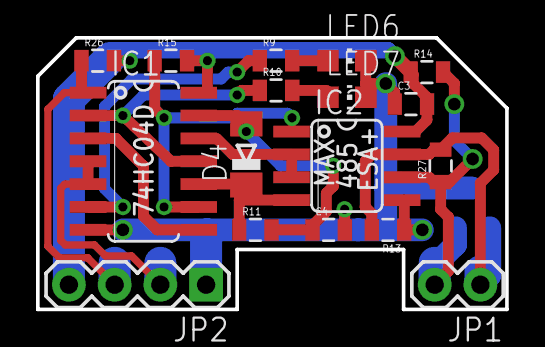
[picture p16: board Adaptor485mini.BRD from above]

Board: 2 copper layers, 26.1 x 15.1 mm, 18 parts (1 on the bottom side), 15 nets.
