NedelcuBogdanSebastian/SistemAchizitie/MODULE/AQETHBluePill_w_RESET/AQETHBluePill_w_RESET.brd

## EAGLE design MODULE/AQETHBluePill_w_RESET/AQETHBluePill_w_RESET.brd (2024-10-08)

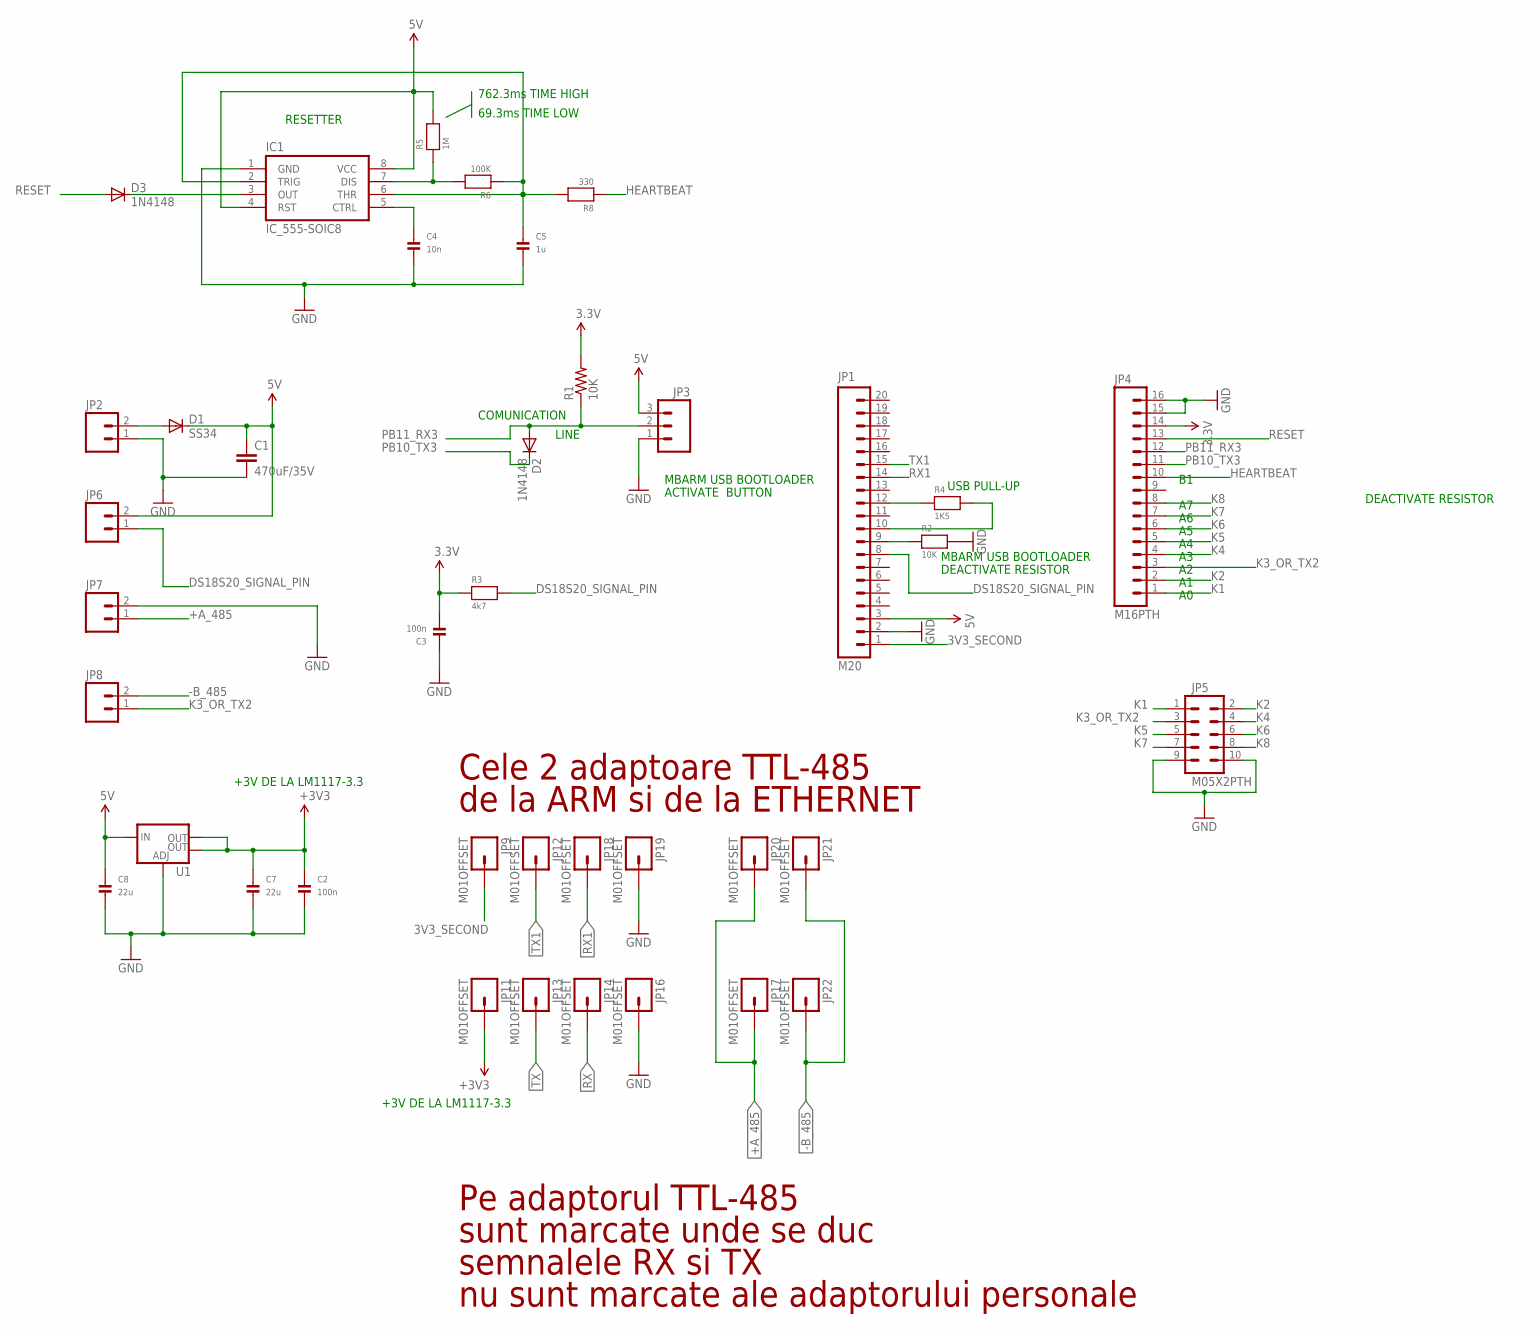
[picture p17: schematic AQETHBluePill_w_RESET.sch]

Parts:
C1: 470uF/35V; CAP-PTH-5MM
C2, C3: 100n; _0805MP
C4: 10n; _0805MP
C5: 1u; 1206
C7, C8: 22u; 1206
D1: SS34; SMC
D2, D3: 1N4148; MINIMELF
IC1: IC_555-SOIC8; SOIC-8
JP1: M20; 1X20
JP2, JP6, JP7, JP8: M025MM; SCREWTERMINAL-5MM-2
JP3: M03LOCK_LONGPADS; 1X03_LOCK_LONGPADS
JP4: M16PTH; 1X16
JP5: M05X2PTH; AVR_ICSP
JP9, JP11, JP12, JP13, JP14, JP16, JP17, JP18, JP19, JP20, JP21, JP22: M01OFFSET; 1X01_OFFSET
R1: 10K; 1206
R2: 10K; _0805MP
R3: 4k7; _0805MP
R4: 1K5; _0805MP
R5: 1M; _0805MP
R6: 100K; _0805MP
R8: 330; _0805MP
U1: V_REG_LM1117SOT223; SOT223

Connections:
3.3V: C3.2, JP4.14, R1.2, R3.1
3V3_SECOND: JP1.1, JP9.1
5V: C1.1, C8.1, D1.C, IC1.4 (RST), IC1.8 (VCC), JP1.3, JP3.3, JP6.2, R5.2, U1.3 (IN)
+A_485: JP7.1, JP17.1, JP20.1
-B_485: JP8.2, JP21.1, JP22.1
CTRL: C4.1, IC1.5 (CTRL)
DS18S20_SIGNAL_PIN: JP1.8, JP6.1, R3.2
GND: C1.2, C2.2, C3.1, C4.2, C5.2, C7.2, C8.2, IC1.1 (GND), JP1.2, JP2.1, JP3.1, JP4.15, JP4.16, JP5.9, JP5.10, JP7.2, JP16.1, JP19.1, R2.2, U1.1 (ADJ)
HEARTBEAT: JP4.10, R8.1
K1: JP4.1, JP5.1
K2: JP4.2, JP5.2
K3_OR_TX2: JP4.3, JP5.3, JP8.1
K4: JP4.4, JP5.4
K5: JP4.5, JP5.5
K6: JP4.6, JP5.6
K7: JP4.7, JP5.7
K8: JP4.8, JP5.8
unnamed: JP1.10, R4.2
unnamed: JP1.9, R2.1
unnamed: JP1.12, R4.1
unnamed: C5.1, IC1.2 (TRIG), IC1.6 (THR), R6.1, R8.2
unnamed: D3.C, IC1.3 (OUT)
unnamed: IC1.7 (DIS), R5.1, R6.2
unnamed: D1.A, JP2.2
PB10_TX3: D2.C, JP4.11
PB11_RX3: D2.A, JP3.2, JP4.12, R1.1
RESET: D3.A, JP4.13
RX: JP14.1
RX1: JP1.14, JP18.1
TX: JP13.1
TX1: JP1.15, JP12.1
VCC: C2.1, C7.1, JP11.1, U1.2 (OUT), U1.4 (OUT)

Notes on the sheet:
COMUNICATION
LINE
Pe adaptorul TTL-485
sunt marcate unde se duc
semnalele RX si TX
nu sunt marcate ale adaptorului personale
+3V DE LA LM1117-3.3
Cele 2 adaptoare TTL-485
de la ARM si de la ETHERNET
USB PULL-UP
MBARM USB BOOTLOADER
DEACTIVATE RESISTOR
ACTIVATE BUTTON
69.3ms TIME LOW
762.3ms TIME HIGH
RESETTER

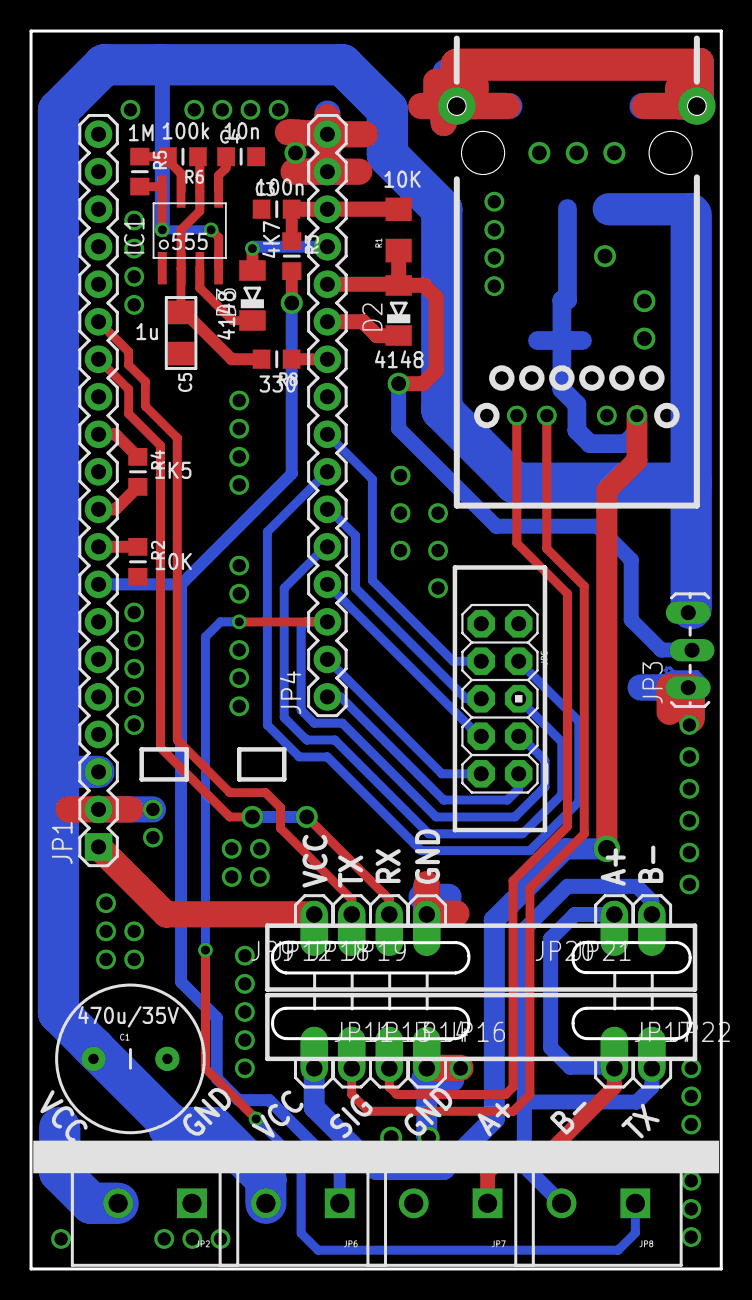
[picture p18: board AQETHBluePill_w_RESET.brd from above]

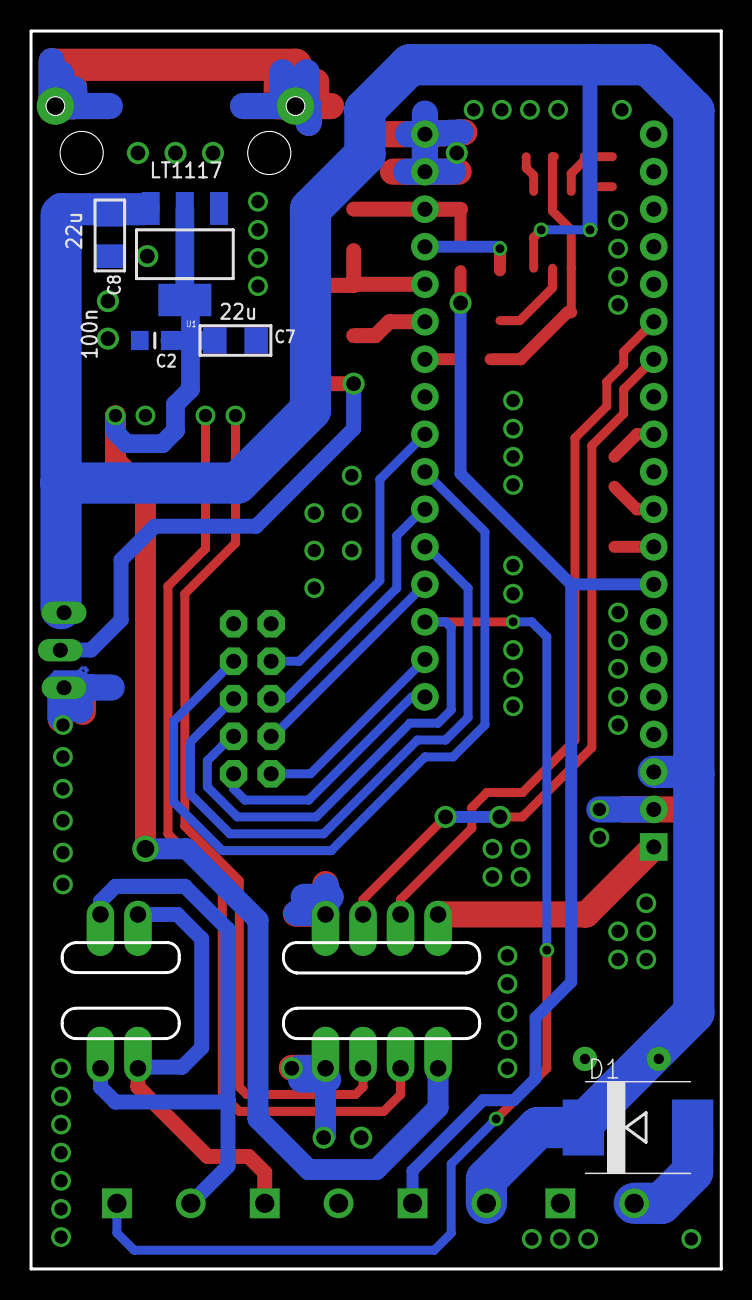
[picture p19: board AQETHBluePill_w_RESET.brd from below]

Board: 2 copper layers, 46.7 x 83.8 mm, 39 parts (5 on the bottom side), 30 nets.
