NedelcuBogdanSebastian/SistemAchizitie/MODULE/PT100Module/PT100RTD_pt_Elecrow.brd

## EAGLE design MODULE/PT100Module/PT100RTD_pt_Elecrow.brd (2024-10-08)

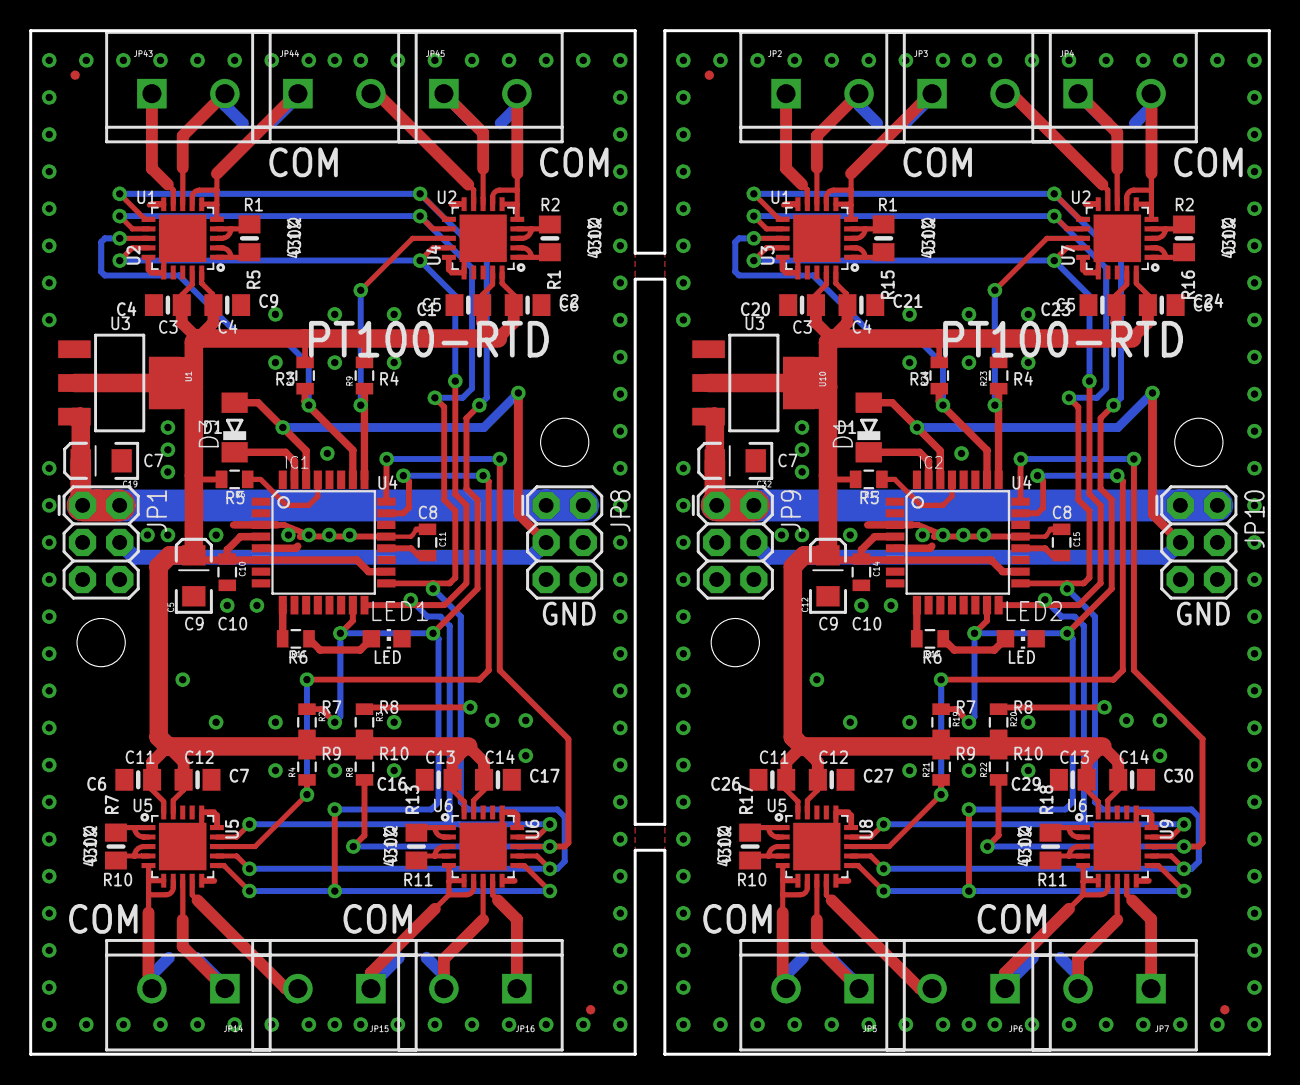
[picture p20: board PT100RTD_pt_Elecrow.brd from above]

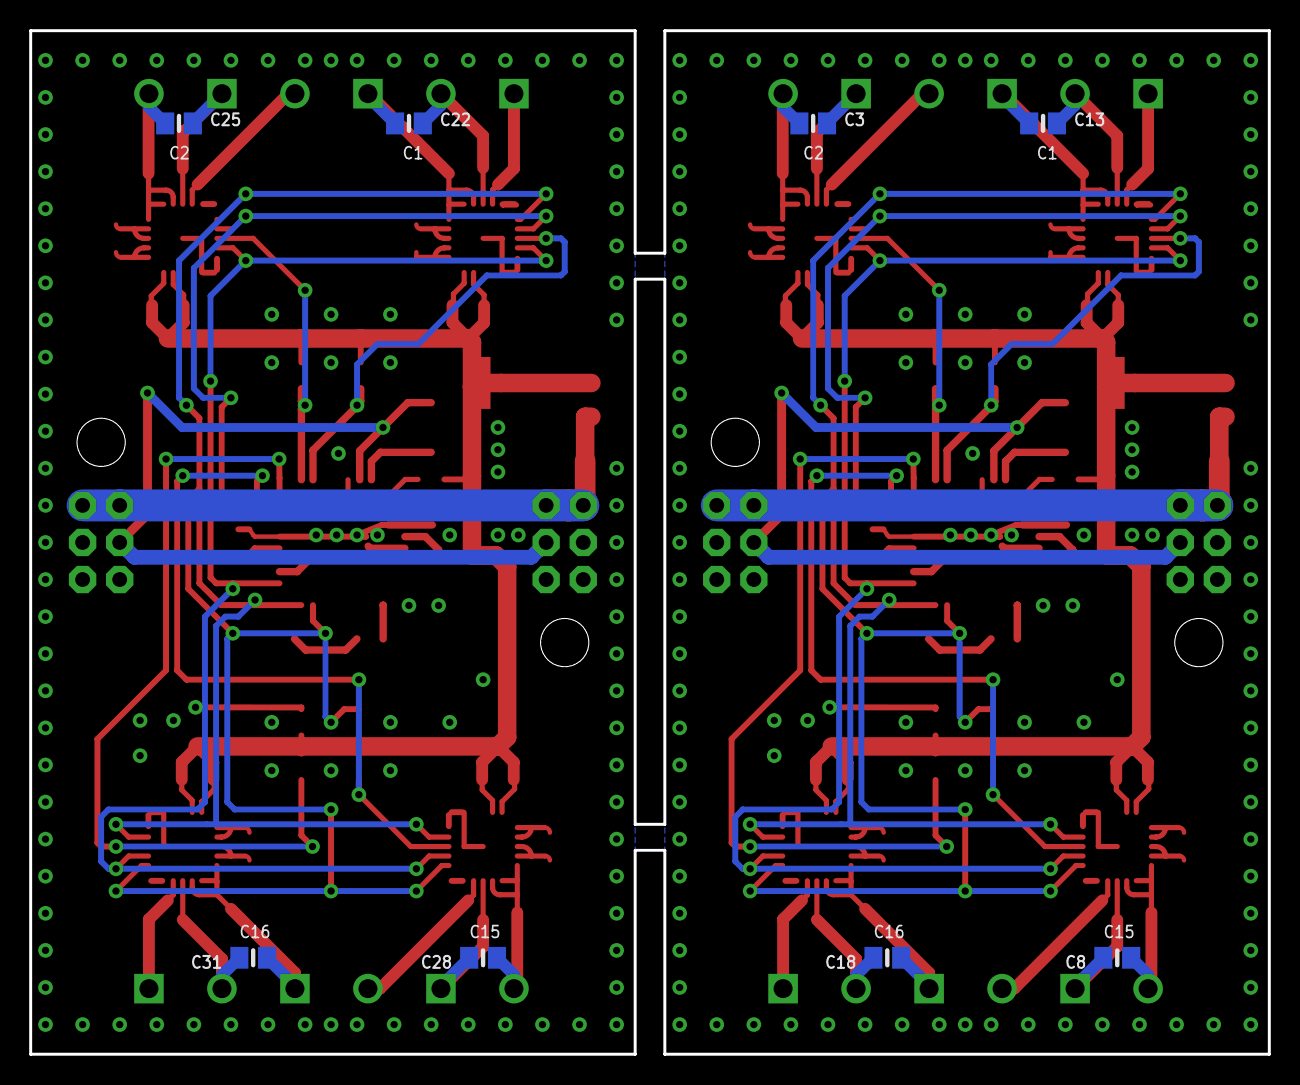
[picture p21: board PT100RTD_pt_Elecrow.brd from below]

Board: 2 copper layers, 84.8 x 70.1 mm, 96 parts (8 on the bottom side), 72 nets.

Parts:
C1, C2, C4, C6, C7, C9, C16, C17, C20, C21, C23, C24, C26, C27, C29, C30: 0.1uF; 0805-NO
C3, C8, C13, C18, C22, C25, C28, C31: 100nF; 0805-NO
C5, C12, C19, C32: 22uF/16V; EIA3216
C10, C11, C14, C15: 100n; 0805
D1, D3: 1N4148; MINIMELF
FD1, FD2, FD3, FD4: FIDUCIALUFIDUCIAL; FIDUCIAL-MICRO
IC1, IC2: MEGA8-AI; TQFP32-08
JP1, JP8, JP9, JP10: 2X3
JP2, JP3, JP4, JP5, JP6, JP7, JP14, JP15, JP16, JP43, JP44, JP45: SCREWTERMINAL-5MM-2
LED1, LED2: CHIP-LED0805
R1, R5, R7, R13, R15, R16, R17, R18: 430Ω/0.1%; 0805-NO
R2, R3, R4, R6, R8, R9, R10, R12, R19, R20, R21, R22, R23, R24: 10K; 0805
R11, R14: 0805
STANDOFF1, STANDOFF2, STANDOFF3, STANDOFF4: STAND-OFF
U1, U10: SOT223
U2, U3, U4, U5, U6, U7, U8, U9: MAX31865; QFN20_4MM_0.65MM

Connections:
5V: C19.A, JP1.1, JP1.2, JP8.1, JP8.2, U1.3
5V1: C32.A, JP9.1, JP9.2, JP10.1, JP10.2, U10.3
COM1: D3.A, IC1.30, JP1.4, JP8.3
COM2: D1.A, IC2.30, JP9.4, JP10.3
CS1: IC1.26, R10.1, U2.13
CS2: IC1.25, R9.1, U4.13
CS3: IC1.23, R4.1, U5.13
CS4: IC1.24, R8.1, U6.13
CS5: IC2.26, R24.1, U3.13
CS6: IC2.25, R23.1, U7.13
CS7: IC2.23, R21.1, U8.13
CS8: IC2.24, R22.1, U9.13
GND: C1.2, C2.2, C4.2, C5.C, C6.2, C7.2, C9.2, C10.2, C11.1, C16.2, C17.2, C19.C, IC1.3, IC1.5, IC1.21, JP1.5, JP1.6, JP8.5, JP8.6, LED1.C, U1.1, U2.10, U2.15, U2.16, U2.PAD, U4.10, U4.15, U4.16, U4.PAD, U5.10, U5.15, U5.16, U5.PAD, U6.10, U6.15, U6.16, U6.PAD
GND4: C12.C, C14.2, C15.1, C20.2, C21.2, C23.2, C24.2, C26.2, C27.2, C29.2, C30.2, C32.C, IC2.3, IC2.5, IC2.21, JP9.5, JP9.6, JP10.5, JP10.6, LED2.C, U3.10, U3.15, U3.16, U3.PAD, U7.10, U7.15, U7.16, U7.PAD, U8.10, U8.15, U8.16, U8.PAD, U9.10, U9.15, U9.16, U9.PAD, U10.1
MISO: IC1.16, U2.14, U4.14, U5.14, U6.14
MISO1: IC2.16, U3.14, U7.14, U8.14, U9.14
MOSI: IC1.15, R2.1, U2.11, U4.11, U5.11, U6.11
MOSI1: IC2.15, R19.1, U3.11, U7.11, U8.11, U9.11
unnamed: LED1.A, R11.1
unnamed: D3.C, IC1.31
unnamed: R5.2, U2.1, U2.2
unnamed: R5.1, U2.3, U2.4
unnamed: C11.2, IC1.20
unnamed: R1.2, U4.1, U4.2
unnamed: R1.1, U4.3, U4.4
unnamed: C15.2, IC2.20
unnamed: R7.2, U5.1, U5.2
unnamed: R7.1, U5.3, U5.4
unnamed: IC1.9, R11.2
unnamed: LED2.A, R14.1
unnamed: R13.2, U6.1, U6.2
unnamed: R13.1, U6.3, U6.4
unnamed: D1.C, IC2.31
unnamed: R15.2, U3.1, U3.2
unnamed: R15.1, U3.3, U3.4
unnamed: R16.2, U7.1, U7.2
unnamed: R16.1, U7.3, U7.4
unnamed: R17.2, U8.1, U8.2
unnamed: R17.1, U8.3, U8.4
unnamed: R18.2, U9.1, U9.2
unnamed: R18.1, U9.3, U9.4
unnamed: IC2.9, R14.2
RESET: IC1.29, R6.1
RESET1: IC2.29, R12.1
SCK: IC1.17, R3.1, U2.12, U4.12, U5.12, U6.12
SCK1: IC2.17, R20.1, U3.12, U7.12, U8.12, U9.12
T1A: C13.1, JP44.1, U2.5, U2.6, U2.7
T1A1: C22.1, JP3.1, U3.5, U3.6, U3.7
T1B: C13.2, JP43.2, U2.8
T1B1: C22.2, JP2.2, U3.8
T1C: JP43.1, U2.9
T1C1: JP2.1, U3.9
T2A: C3.1, JP45.2, U4.5, U4.6, U4.7
T2A1: C25.1, JP4.2, U7.5, U7.6, U7.7
T2B: C3.2, JP45.1, U4.8
T2B1: C25.2, JP4.1, U7.8
T2C: JP44.2, U4.9
T2C1: JP3.2, U7.9
T3A: C8.1, JP14.2, U5.5, U5.6, U5.7
T3A1: C28.1, JP5.2, U8.5, U8.6, U8.7
T3B: C8.2, JP14.1, U5.8
T3B1: C28.2, JP5.1, U8.8
T3C: JP15.2, U5.9
T3C1: JP6.2, U8.9
T4A: C18.1, JP15.1, U6.5, U6.6, U6.7
T4A1: C31.1, JP6.1, U9.5, U9.6, U9.7
T4B: C18.2, JP16.2, U6.8
T4B1: C31.2, JP7.2, U9.8
T4C: JP16.1, U6.9
T4C1: JP7.1, U9.9
VCC: C1.1, C2.1, C4.1, C5.A, C6.1, C7.1, C9.1, C10.1, C16.1, C17.1, IC1.4, IC1.6, IC1.18, R2.2, R3.2, R4.2, R6.2, R8.2, R9.2, R10.2, U1.2, U1.4, U2.19, U2.20, U4.19, U4.20, U5.19, U5.20, U6.19, U6.20
VCC1: C12.A, C14.1, C20.1, C21.1, C23.1, C24.1, C26.1, C27.1, C29.1, C30.1, IC2.4, IC2.6, IC2.18, R12.2, R19.2, R20.2, R21.2, R22.2, R23.2, R24.2, U3.19, U3.20, U7.19, U7.20, U8.19, U8.20, U9.19, U9.20, U10.2, U10.4
