NedelcuBogdanSebastian/SistemAchizitie/MODULE/DigitalModule/DIGITAL2_gerber_JLPCB/DIGITAL2_4_JLPCB.brd

## EAGLE design MODULE/DigitalModule/DIGITAL2_gerber_JLPCB/DIGITAL2_4_JLPCB.brd (2024-10-08)

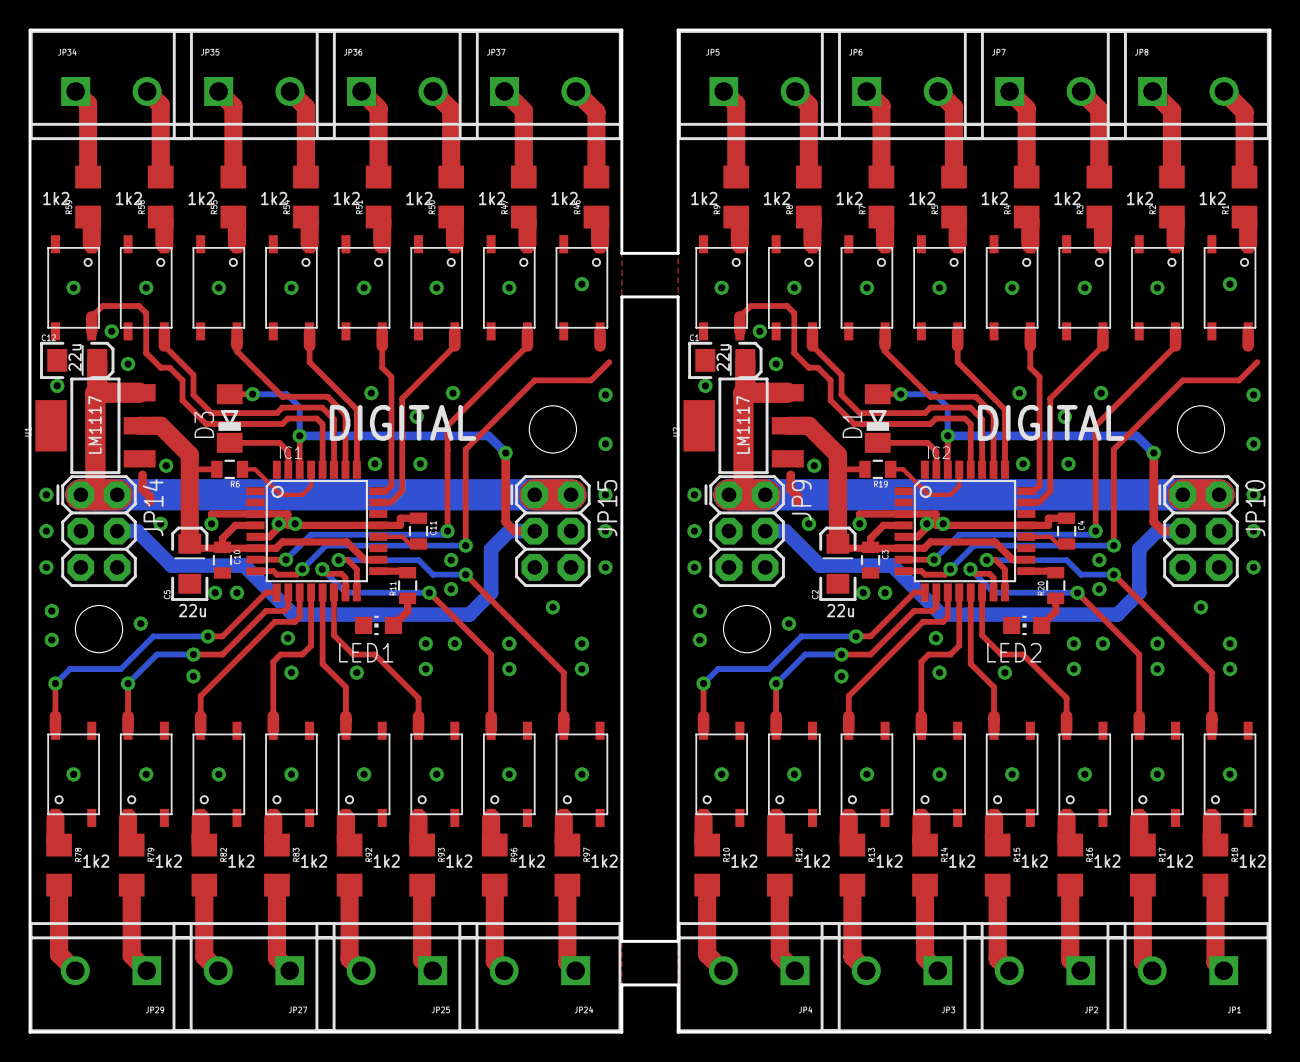
[picture p22: board DIGITAL2_4_JLPCB.brd from above]

Board: 2 copper layers, 86.7 x 70.1 mm, 108 parts (0 on the bottom side), 114 nets.

Parts:
C1, C2, C5, C12: 22uF/16V; EIA3216
C3, C4, C10, C11: 100n; 0805
D1, D3: 1N4148; MINIMELF
IC1, IC2: MEGA8-AI; TQFP32-08
JP1, JP2, JP3, JP4, JP5, JP6, JP7, JP8, JP24, JP25, JP27, JP29, JP34, JP35, JP36, JP37: SCREWTERMINAL-5MM-2
JP9, JP10, JP14, JP15: 2X3
LED1, LED2: CHIP-LED0805
R1, R2, R3, R4, R5, R7, R8, R9, R10, R12, R13, R14, R15, R16, R17, R18, R46, R47, R50, R51, R54, R55, R58, R59, R78, R79, R82, R83, R92, R93, R96, R97: 1.2K; 1206
R6, R19: 10K; 0805
R11, R20: 0805
STANDOFF1, STANDOFF2, STANDOFF3, STANDOFF4: STAND-OFF
U1, U2: SOT223
U$1, U$2, U$3, U$4, U$5, U$6, U$7, U$8, U$9, U$10, U$11, U$12, U$13, U$14, U$15, U$16, U$17, U$18, U$19, U$20, U$21, U$22, U$23, U$24, U$29, U$30, U$31, U$32, U$33, U$34, U$35, U$36: IS181D-I; TLP181-I

Connections:
5V: C12.A, JP14.1, JP14.2, JP15.1, JP15.2, U1.3
5V1: C1.A, JP9.1, JP9.2, JP10.1, JP10.2, U2.3
COM1: D3.A, IC1.30, JP14.4, JP15.3
COM3: D1.A, IC2.30, JP9.4, JP10.3
D1: IC2.9, U$9.P$4
D2: IC2.10, U$10.P$4
D3: IC1.8, U$13.P$4
D4: IC1.7, U$14.P$4
D5: IC1.23, U$15.P$4
D6: IC1.24, U$16.P$4
D7: IC1.25, U$17.P$4
D8: IC1.26, U$18.P$4
D9: IC1.27, U$19.P$4
D10: IC1.28, U$20.P$4
D11: IC1.9, U$29.P$4
D12: IC1.10, U$30.P$4
D13: IC1.11, U$31.P$4
D14: IC1.12, U$32.P$4
D15: IC1.13, U$33.P$4
D16: IC1.14, U$34.P$4
D17: IC1.15, U$35.P$4
D18: IC1.16, U$36.P$4
D19: IC2.11, U$11.P$4
D20: IC2.12, U$12.P$4
D21: IC2.13, U$21.P$4
D22: IC2.14, U$22.P$4
D23: IC2.15, U$23.P$4
D24: IC2.16, U$24.P$4
D25: IC2.8, U$1.P$4
D26: IC2.7, U$2.P$4
D27: IC2.23, U$3.P$4
D28: IC2.24, U$4.P$4
D29: IC2.25, U$5.P$4
D30: IC2.26, U$6.P$4
D31: IC2.27, U$7.P$4
D32: IC2.28, U$8.P$4
GND: C5.C, C10.2, C11.1, C12.C, IC1.3, IC1.5, IC1.21, JP14.5, JP14.6, JP15.5, JP15.6, LED1.C, U1.1, U$13.P$2, U$13.P$3, U$14.P$2, U$14.P$3, U$15.P$2, U$15.P$3, U$16.P$2, U$16.P$3, U$17.P$2, U$17.P$3, U$18.P$2, U$18.P$3, U$19.P$2, U$19.P$3, U$20.P$2, U$20.P$3, U$29.P$2, U$29.P$3, U$30.P$2, U$30.P$3, U$31.P$2, U$31.P$3, U$32.P$2, U$32.P$3, U$33.P$2, U$33.P$3, U$34.P$2, U$34.P$3, U$35.P$2, U$35.P$3, U$36.P$2, U$36.P$3
GND2: C1.C, C2.C, C3.2, C4.1, IC2.3, IC2.5, IC2.21, JP9.5, JP9.6, JP10.5, JP10.6, LED2.C, U2.1, U$1.P$2, U$1.P$3, U$2.P$2, U$2.P$3, U$3.P$2, U$3.P$3, U$4.P$2, U$4.P$3, U$5.P$2, U$5.P$3, U$6.P$2, U$6.P$3, U$7.P$2, U$7.P$3, U$8.P$2, U$8.P$3, U$9.P$2, U$9.P$3, U$10.P$2, U$10.P$3, U$11.P$2, U$11.P$3, U$12.P$2, U$12.P$3, U$21.P$2, U$21.P$3, U$22.P$2, U$22.P$3, U$23.P$2, U$23.P$3, U$24.P$2, U$24.P$3
unnamed: LED1.A, R11.1
unnamed: JP8.2, R1.2
unnamed: D3.C, IC1.31
unnamed: JP29.2, R78.2
unnamed: C11.2, IC1.20
unnamed: JP27.2, R82.2
unnamed: JP25.2, R92.2
unnamed: JP8.1, R2.2
unnamed: R1.1, U$1.P$1
unnamed: R2.1, U$2.P$1
unnamed: JP24.2, R96.2
unnamed: JP7.2, R3.2
unnamed: JP7.1, R4.2
unnamed: R3.1, U$3.P$1
unnamed: R4.1, U$4.P$1
unnamed: JP6.2, R5.2
unnamed: JP6.1, R7.2
unnamed: R5.1, U$5.P$1
unnamed: R7.1, U$6.P$1
unnamed: JP27.1, R83.2
unnamed: JP5.2, R8.2
unnamed: JP5.1, R9.2
unnamed: JP25.1, R93.2
unnamed: R8.1, U$7.P$1
unnamed: R9.1, U$8.P$1
unnamed: JP4.1, R12.2
unnamed: R10.1, U$9.P$1
unnamed: JP24.1, R97.2
unnamed: R12.1, U$10.P$1
unnamed: R13.1, U$11.P$1
unnamed: R14.1, U$12.P$1
unnamed: R15.1, U$21.P$1
unnamed: R16.1, U$22.P$1
unnamed: R17.1, U$23.P$1
unnamed: R18.1, U$24.P$1
unnamed: JP3.1, R14.2
unnamed: JP2.1, R16.2
unnamed: JP1.1, R18.2
unnamed: JP4.2, R10.2
unnamed: JP3.2, R13.2
unnamed: JP2.2, R15.2
unnamed: JP1.2, R17.2
unnamed: C4.2, IC2.20
unnamed: LED2.A, R20.1
unnamed: D1.C, IC2.31
unnamed: JP37.2, R46.2
unnamed: JP37.1, R47.2
unnamed: R46.1, U$13.P$1
unnamed: R47.1, U$14.P$1
unnamed: JP36.2, R50.2
unnamed: JP36.1, R51.2
unnamed: R50.1, U$15.P$1
unnamed: R51.1, U$16.P$1
unnamed: JP35.2, R54.2
unnamed: JP35.1, R55.2
unnamed: R54.1, U$17.P$1
unnamed: R55.1, U$18.P$1
unnamed: JP34.2, R58.2
unnamed: JP34.1, R59.2
unnamed: R58.1, U$19.P$1
unnamed: R59.1, U$20.P$1
unnamed: JP29.1, R79.2
unnamed: R78.1, U$29.P$1
unnamed: R79.1, U$30.P$1
unnamed: R82.1, U$31.P$1
unnamed: R83.1, U$32.P$1
unnamed: R92.1, U$33.P$1
unnamed: R93.1, U$34.P$1
unnamed: R96.1, U$35.P$1
unnamed: R97.1, U$36.P$1
RESET: IC1.29, R6.1
RESET2: IC2.29, R19.1
SCK: IC1.17, R11.2
SCK2: IC2.17, R20.2
VCC: C5.A, C10.1, IC1.4, IC1.6, IC1.18, R6.2, U1.2, U1.4
VCC2: C2.A, C3.1, IC2.4, IC2.6, IC2.18, R19.2, U2.2, U2.4
