NedelcuBogdanSebastian/SistemAchizitie/MODULE/AQETHBluePill_w_RESET/GERB_Adaptor485mini/Adaptor485mini_MODIF_PT_ELECROW.BRD

## EAGLE design MODULE/AQETHBluePill_w_RESET/GERB_Adaptor485mini/Adaptor485mini_MODIF_PT_ELECROW.BRD (2024-10-08)

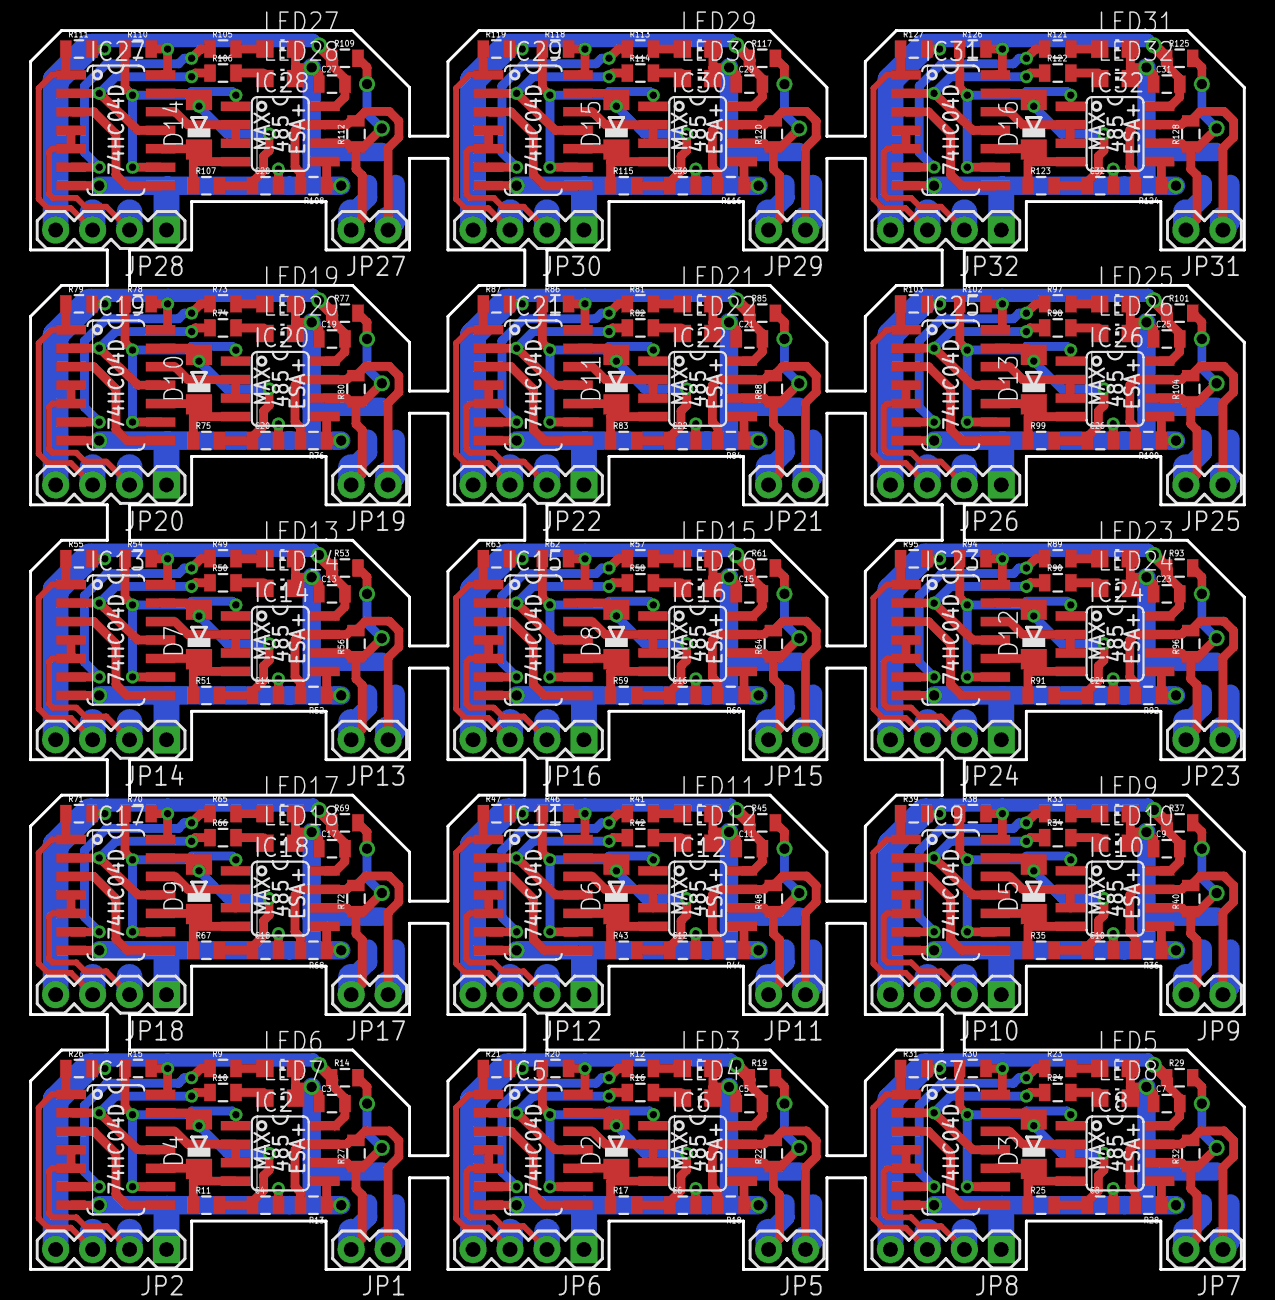
[picture p23: board Adaptor485mini_MODIF_PT_ELECROW.BRD from above]

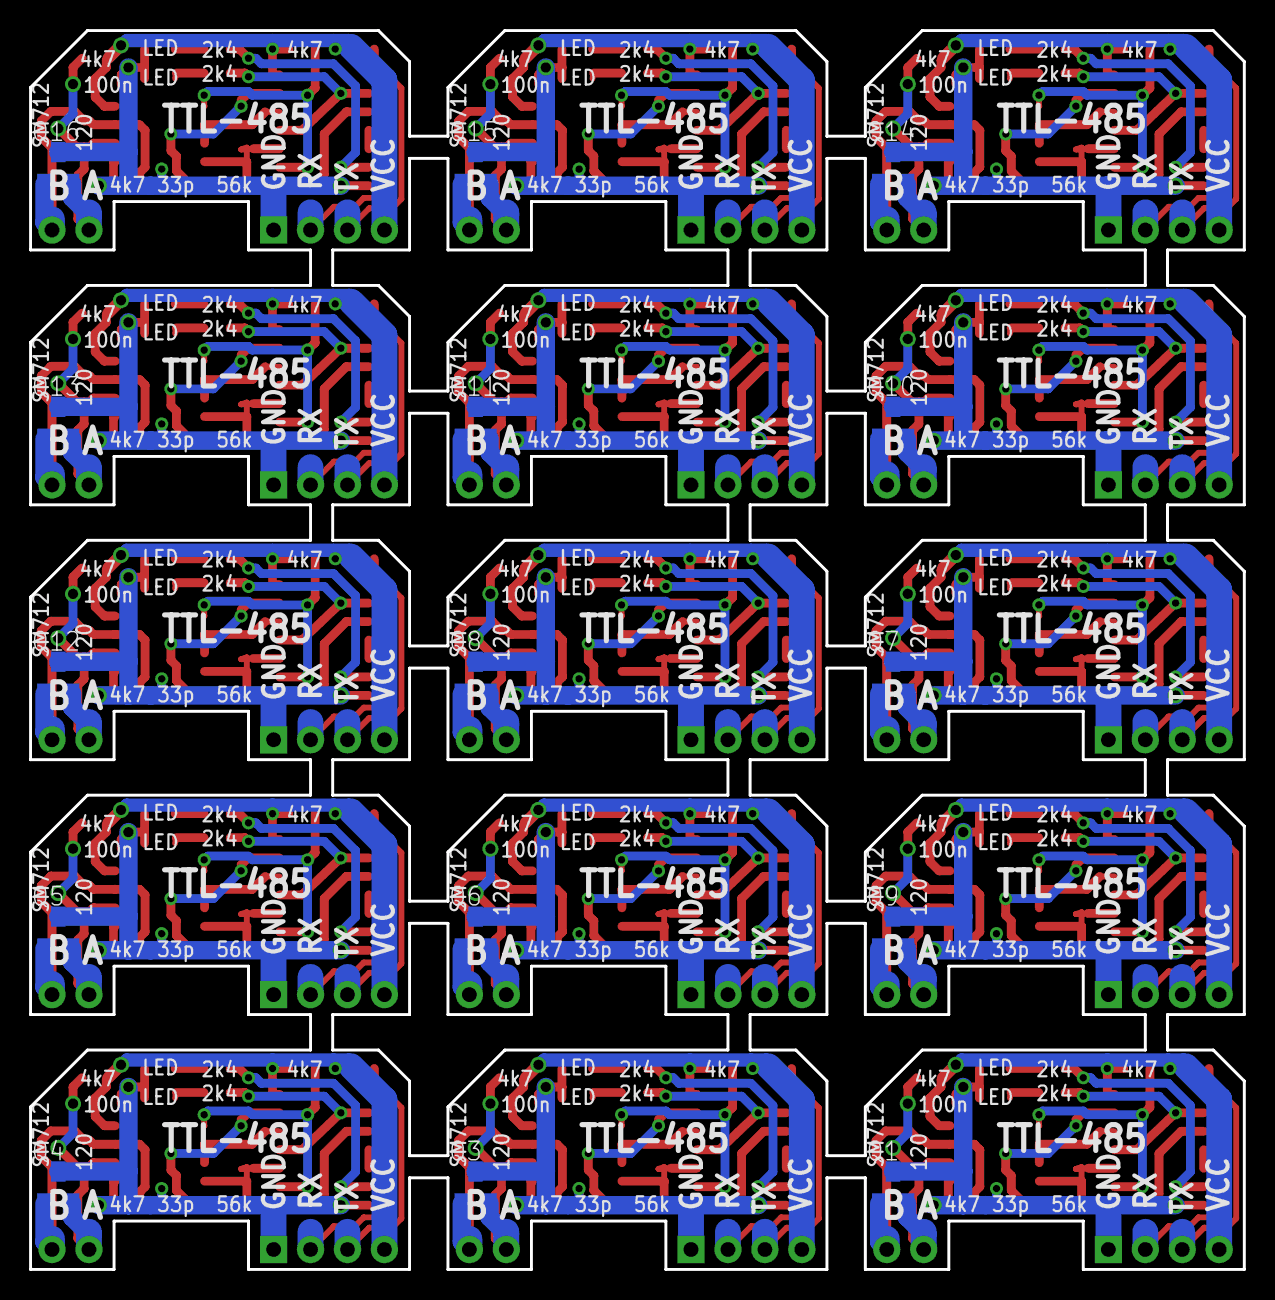
[picture p24: board Adaptor485mini_MODIF_PT_ELECROW.BRD from below]

Board: 2 copper layers, 83.5 x 85.2 mm, 270 parts (15 on the bottom side), 225 nets.

Parts:
C3, C5, C7, C9, C11, C13, C15, C17, C19, C21, C23, C25, C27, C29, C31: 100n; 0805
C4, C6, C8, C10, C12, C14, C16, C18, C20, C22, C24, C26, C28, C30, C32: 33pF; 0805
D2, D3, D4, D5, D6, D7, D8, D9, D10, D11, D12, D13, D14, D15, D16: 1N4148; MINIMELF
IC1, IC5, IC7, IC9, IC11, IC13, IC15, IC17, IC19, IC21, IC23, IC25, IC27, IC29, IC31: 74HC04D; SO14
IC2, IC6, IC8, IC10, IC12, IC14, IC16, IC18, IC20, IC22, IC24, IC26, IC28, IC30, IC32: MAX3468CSA; SO08
JP1, JP5, JP7, JP9, JP11, JP13, JP15, JP17, JP19, JP21, JP23, JP25, JP27, JP29, JP31: 1X02
JP2, JP6, JP8, JP10, JP12, JP14, JP16, JP18, JP20, JP22, JP24, JP26, JP28, JP30, JP32: 1X04
LED3, LED4, LED5, LED6, LED7, LED8, LED9, LED10, LED11, LED12, LED13, LED14, LED15, LED16, LED17, LED18, LED19, LED20, LED21, LED22, LED23, LED24, LED25, LED26, LED27, LED28, LED29, LED30, LED31, LED32: CHIP-LED0805
Q1, Q3, Q4, Q5, Q6, Q7, Q8, Q9, Q10, Q11, Q12, Q13, Q14, Q15, Q16: BCX70SMD; SOT23
R9, R10, R12, R16, R23, R24, R33, R34, R41, R42, R49, R50, R57, R58, R65, R66, R73, R74, R81, R82, R89, R90, R97, R98, R105, R106, R113, R114, R121, R122: 2K4; 0805
R11, R17, R25, R35, R43, R51, R59, R67, R75, R83, R91, R99, R107, R115, R123: 56K; 0805
R13, R14, R15, R18, R19, R20, R21, R26, R28, R29, R30, R31, R36, R37, R38, R39, R44, R45, R46, R47, R52, R53, R54, R55, R60, R61, R62, R63, R68, R69, R70, R71, R76, R77, R78, R79, R84, R85, R86, R87, R92, R93, R94, R95, R100, R101, R102, R103, R108, R109, R110, R111, R116, R117, R118, R119, R124, R125, R126, R127: 4K7; 0805
R22, R27, R32, R40, R48, R56, R64, R72, R80, R88, R96, R104, R112, R120, R128: 120; 0805

Connections:
3.3V: C3.2, IC1.14, IC2.8, JP2.4, R14.1, R15.2, R26.2
3.3V2: C5.2, IC5.14, IC6.8, JP6.4, R19.1, R20.2, R21.2
3.3V3: C7.2, IC7.14, IC8.8, JP8.4, R29.1, R30.2, R31.2
3.3V4: C9.2, IC9.14, IC10.8, JP10.4, R37.1, R38.2, R39.2
3.3V5: C11.2, IC11.14, IC12.8, JP12.4, R45.1, R46.2, R47.2
3.3V6: C13.2, IC13.14, IC14.8, JP14.4, R53.1, R54.2, R55.2
3.3V7: C15.2, IC15.14, IC16.8, JP16.4, R61.1, R62.2, R63.2
3.3V8: C17.2, IC17.14, IC18.8, JP18.4, R69.1, R70.2, R71.2
3.3V9: C19.2, IC19.14, IC20.8, JP20.4, R77.1, R78.2, R79.2
3.3V10: C21.2, IC21.14, IC22.8, JP22.4, R85.1, R86.2, R87.2
3.3V11: C23.2, IC23.14, IC24.8, JP24.4, R93.1, R94.2, R95.2
3.3V12: C25.2, IC25.14, IC26.8, JP26.4, R101.1, R102.2, R103.2
3.3V13: C27.2, IC27.14, IC28.8, JP28.4, R109.1, R110.2, R111.2
3.3V14: C29.2, IC29.14, IC30.8, JP30.4, R117.1, R118.2, R119.2
3.3V15: C31.2, IC31.14, IC32.8, JP32.4, R125.1, R126.2, R127.2
A+: IC2.6, JP1.2, Q1.2, R14.2, R27.1
A+2: IC6.6, JP5.2, Q3.2, R19.2, R22.1
A+3: IC8.6, JP7.2, Q4.2, R29.2, R32.1
A+4: IC10.6, JP9.2, Q5.2, R37.2, R40.1
A+5: IC12.6, JP11.2, Q6.2, R45.2, R48.1
A+6: IC14.6, JP13.2, Q7.2, R53.2, R56.1
A+7: IC16.6, JP15.2, Q8.2, R61.2, R64.1
A+8: IC18.6, JP17.2, Q9.2, R69.2, R72.1
A+9: IC20.6, JP19.2, Q10.2, R77.2, R80.1
A+10: IC22.6, JP21.2, Q11.2, R85.2, R88.1
A+11: IC24.6, JP23.2, Q12.2, R93.2, R96.1
A+12: IC26.6, JP25.2, Q13.2, R101.2, R104.1
A+13: IC28.6, JP27.2, Q14.2, R109.2, R112.1
A+14: IC30.6, JP29.2, Q15.2, R117.2, R120.1
A+15: IC32.6, JP31.2, Q16.2, R125.2, R128.1
B-: IC2.7, JP1.1, Q1.1, R13.2, R27.2
B-2: IC6.7, JP5.1, Q3.1, R18.2, R22.2
B-3: IC8.7, JP7.1, Q4.1, R28.2, R32.2
B-4: IC10.7, JP9.1, Q5.1, R36.2, R40.2
B-5: IC12.7, JP11.1, Q6.1, R44.2, R48.2
B-6: IC14.7, JP13.1, Q7.1, R52.2, R56.2
B-7: IC16.7, JP15.1, Q8.1, R60.2, R64.2
B-8: IC18.7, JP17.1, Q9.1, R68.2, R72.2
B-9: IC20.7, JP19.1, Q10.1, R76.2, R80.2
B-10: IC22.7, JP21.1, Q11.1, R84.2, R88.2
B-11: IC24.7, JP23.1, Q12.1, R92.2, R96.2
B-12: IC26.7, JP25.1, Q13.1, R100.2, R104.2
B-13: IC28.7, JP27.1, Q14.1, R108.2, R112.2
B-14: IC30.7, JP29.1, Q15.1, R116.2, R120.2
B-15: IC32.7, JP31.1, Q16.1, R124.2, R128.2
GND: C3.1, C4.2, IC1.7, IC2.5, JP2.1, LED6.C, LED7.C, Q1.3, R13.1
GND3: C5.1, C6.2, IC5.7, IC6.5, JP6.1, LED3.C, LED4.C, Q3.3, R18.1
GND4: C7.1, C8.2, IC7.7, IC8.5, JP8.1, LED5.C, LED8.C, Q4.3, R28.1
GND5: C9.1, C10.2, IC9.7, IC10.5, JP10.1, LED9.C, LED10.C, Q5.3, R36.1
GND6: C11.1, C12.2, IC11.7, IC12.5, JP12.1, LED11.C, LED12.C, Q6.3, R44.1
GND7: C13.1, C14.2, IC13.7, IC14.5, JP14.1, LED13.C, LED14.C, Q7.3, R52.1
GND8: C15.1, C16.2, IC15.7, IC16.5, JP16.1, LED15.C, LED16.C, Q8.3, R60.1
GND9: C17.1, C18.2, IC17.7, IC18.5, JP18.1, LED17.C, LED18.C, Q9.3, R68.1
GND10: C19.1, C20.2, IC19.7, IC20.5, JP20.1, LED19.C, LED20.C, Q10.3, R76.1
GND11: C21.1, C22.2, IC21.7, IC22.5, JP22.1, LED21.C, LED22.C, Q11.3, R84.1
GND12: C23.1, C24.2, IC23.7, IC24.5, JP24.1, LED23.C, LED24.C, Q12.3, R92.1
GND13: C25.1, C26.2, IC25.7, IC26.5, JP26.1, LED25.C, LED26.C, Q13.3, R100.1
GND14: C27.1, C28.2, IC27.7, IC28.5, JP28.1, LED27.C, LED28.C, Q14.3, R108.1
GND15: C29.1, C30.2, IC29.7, IC30.5, JP30.1, LED29.C, LED30.C, Q15.3, R116.1
GND16: C31.1, C32.2, IC31.7, IC32.5, JP32.1, LED31.C, LED32.C, Q16.3, R124.1
unnamed: IC5.9, IC6.1, R20.1
unnamed: IC5.3, IC5.8
unnamed: C6.1, D2.A, IC5.13, R17.2
unnamed: IC5.6, R12.1
unnamed: D2.C, IC5.10, IC6.4, R17.1
unnamed: IC5.12, IC6.2, IC6.3
unnamed: LED7.A, R10.2
unnamed: LED6.A, R9.2
unnamed: LED4.A, R16.2
unnamed: IC1.2, IC1.11, R10.1
unnamed: LED3.A, R12.2
unnamed: IC1.9, IC2.1, R15.1
unnamed: IC5.2, IC5.11, R16.1
unnamed: IC1.3, IC1.8
unnamed: C4.1, D4.A, IC1.13, R11.2
unnamed: IC7.9, IC8.1, R30.1
unnamed: IC7.3, IC7.8
unnamed: IC1.6, R9.1
unnamed: C8.1, D3.A, IC7.13, R25.2
unnamed: D4.C, IC1.10, IC2.4, R11.1
unnamed: IC1.12, IC2.2, IC2.3
unnamed: IC7.6, R23.1
unnamed: D3.C, IC7.10, IC8.4, R25.1
unnamed: IC7.12, IC8.2, IC8.3
unnamed: LED8.A, R24.2
unnamed: LED5.A, R23.2
unnamed: IC7.2, IC7.11, R24.1
unnamed: IC9.9, IC10.1, R38.1
unnamed: IC9.3, IC9.8
unnamed: C10.1, D5.A, IC9.13, R35.2
unnamed: IC9.6, R33.1
unnamed: D5.C, IC9.10, IC10.4, R35.1
unnamed: IC9.12, IC10.2, IC10.3
unnamed: LED10.A, R34.2
unnamed: LED9.A, R33.2
unnamed: IC9.2, IC9.11, R34.1
unnamed: IC11.9, IC12.1, R46.1
unnamed: IC11.3, IC11.8
unnamed: C12.1, D6.A, IC11.13, R43.2
unnamed: IC11.6, R41.1
unnamed: D6.C, IC11.10, IC12.4, R43.1
unnamed: IC11.12, IC12.2, IC12.3
unnamed: LED12.A, R42.2
unnamed: LED11.A, R41.2
unnamed: IC11.2, IC11.11, R42.1
unnamed: IC13.9, IC14.1, R54.1
unnamed: IC13.3, IC13.8
unnamed: C14.1, D7.A, IC13.13, R51.2
unnamed: IC13.6, R49.1
unnamed: D7.C, IC13.10, IC14.4, R51.1
unnamed: IC13.12, IC14.2, IC14.3
unnamed: LED14.A, R50.2
unnamed: LED13.A, R49.2
unnamed: IC13.2, IC13.11, R50.1
unnamed: IC15.9, IC16.1, R62.1
unnamed: IC15.3, IC15.8
unnamed: C16.1, D8.A, IC15.13, R59.2
unnamed: IC15.6, R57.1
unnamed: D8.C, IC15.10, IC16.4, R59.1
unnamed: IC15.12, IC16.2, IC16.3
unnamed: LED16.A, R58.2
unnamed: LED15.A, R57.2
unnamed: IC15.2, IC15.11, R58.1
unnamed: IC17.9, IC18.1, R70.1
unnamed: IC17.3, IC17.8
unnamed: C18.1, D9.A, IC17.13, R67.2
unnamed: IC17.6, R65.1
unnamed: D9.C, IC17.10, IC18.4, R67.1
unnamed: IC17.12, IC18.2, IC18.3
unnamed: LED18.A, R66.2
unnamed: LED17.A, R65.2
unnamed: IC17.2, IC17.11, R66.1
unnamed: IC19.9, IC20.1, R78.1
unnamed: IC19.3, IC19.8
unnamed: C20.1, D10.A, IC19.13, R75.2
unnamed: IC19.6, R73.1
unnamed: D10.C, IC19.10, IC20.4, R75.1
unnamed: IC19.12, IC20.2, IC20.3
unnamed: LED20.A, R74.2
unnamed: LED19.A, R73.2
unnamed: IC19.2, IC19.11, R74.1
unnamed: IC21.9, IC22.1, R86.1
unnamed: IC21.3, IC21.8
unnamed: C22.1, D11.A, IC21.13, R83.2
unnamed: IC21.6, R81.1
unnamed: D11.C, IC21.10, IC22.4, R83.1
unnamed: IC21.12, IC22.2, IC22.3
unnamed: LED22.A, R82.2
unnamed: LED21.A, R81.2
unnamed: IC21.2, IC21.11, R82.1
unnamed: IC23.9, IC24.1, R94.1
unnamed: IC23.3, IC23.8
unnamed: C24.1, D12.A, IC23.13, R91.2
unnamed: IC23.6, R89.1
unnamed: D12.C, IC23.10, IC24.4, R91.1
unnamed: IC23.12, IC24.2, IC24.3
unnamed: LED24.A, R90.2
unnamed: LED23.A, R89.2
unnamed: IC23.2, IC23.11, R90.1
unnamed: IC25.9, IC26.1, R102.1
unnamed: IC25.3, IC25.8
unnamed: C26.1, D13.A, IC25.13, R99.2
unnamed: IC25.6, R97.1
unnamed: D13.C, IC25.10, IC26.4, R99.1
unnamed: IC25.12, IC26.2, IC26.3
unnamed: LED26.A, R98.2
unnamed: LED25.A, R97.2
unnamed: IC25.2, IC25.11, R98.1
unnamed: IC27.9, IC28.1, R110.1
unnamed: IC27.3, IC27.8
unnamed: C28.1, D14.A, IC27.13, R107.2
unnamed: IC27.6, R105.1
unnamed: D14.C, IC27.10, IC28.4, R107.1
unnamed: IC27.12, IC28.2, IC28.3
unnamed: LED28.A, R106.2
unnamed: LED27.A, R105.2
unnamed: IC27.2, IC27.11, R106.1
unnamed: IC29.9, IC30.1, R118.1
unnamed: IC29.3, IC29.8
unnamed: C30.1, D15.A, IC29.13, R115.2
unnamed: IC29.6, R113.1
unnamed: D15.C, IC29.10, IC30.4, R115.1
unnamed: IC29.12, IC30.2, IC30.3
unnamed: LED30.A, R114.2
unnamed: LED29.A, R113.2
unnamed: IC29.2, IC29.11, R114.1
unnamed: IC31.9, IC32.1, R126.1
unnamed: IC31.3, IC31.8
unnamed: C32.1, D16.A, IC31.13, R123.2
unnamed: IC31.6, R121.1
unnamed: D16.C, IC31.10, IC32.4, R123.1
unnamed: IC31.12, IC32.2, IC32.3
unnamed: LED32.A, R122.2
unnamed: LED31.A, R121.2
unnamed: IC31.2, IC31.11, R122.1
RX: IC1.1, JP2.3, R26.1
RX2: IC5.1, JP6.3, R21.1
RX3: IC7.1, JP8.3, R31.1
RX4: IC9.1, JP10.3, R39.1
RX5: IC11.1, JP12.3, R47.1
RX6: IC13.1, JP14.3, R55.1
RX7: IC15.1, JP16.3, R63.1
RX8: IC17.1, JP18.3, R71.1
RX9: IC19.1, JP20.3, R79.1
RX10: IC21.1, JP22.3, R87.1
RX11: IC23.1, JP24.3, R95.1
RX12: IC25.1, JP26.3, R103.1
RX13: IC27.1, JP28.3, R111.1
RX14: IC29.1, JP30.3, R119.1
RX15: IC31.1, JP32.3, R127.1
TX: IC1.4, IC1.5, JP2.2
TX2: IC5.4, IC5.5, JP6.2
TX3: IC7.4, IC7.5, JP8.2
TX4: IC9.4, IC9.5, JP10.2
TX5: IC11.4, IC11.5, JP12.2
TX6: IC13.4, IC13.5, JP14.2
TX7: IC15.4, IC15.5, JP16.2
TX8: IC17.4, IC17.5, JP18.2
TX9: IC19.4, IC19.5, JP20.2
TX10: IC21.4, IC21.5, JP22.2
TX11: IC23.4, IC23.5, JP24.2
TX12: IC25.4, IC25.5, JP26.2
TX13: IC27.4, IC27.5, JP28.2
TX14: IC29.4, IC29.5, JP30.2
TX15: IC31.4, IC31.5, JP32.2
