NedelcuBogdanSebastian/SistemAchizitie/MODULE/AQETHBluePill_w_RESET/AQETHBluePill_w_RESET_MOD4ELECROW/AQETHBluePill_w_RESET_MOD4ELECROW.brd

## EAGLE design MODULE/AQETHBluePill_w_RESET/AQETHBluePill_w_RESET_MOD4ELECROW/AQETHBluePill_w_RESET_MOD4ELECROW.brd (2024-10-08)

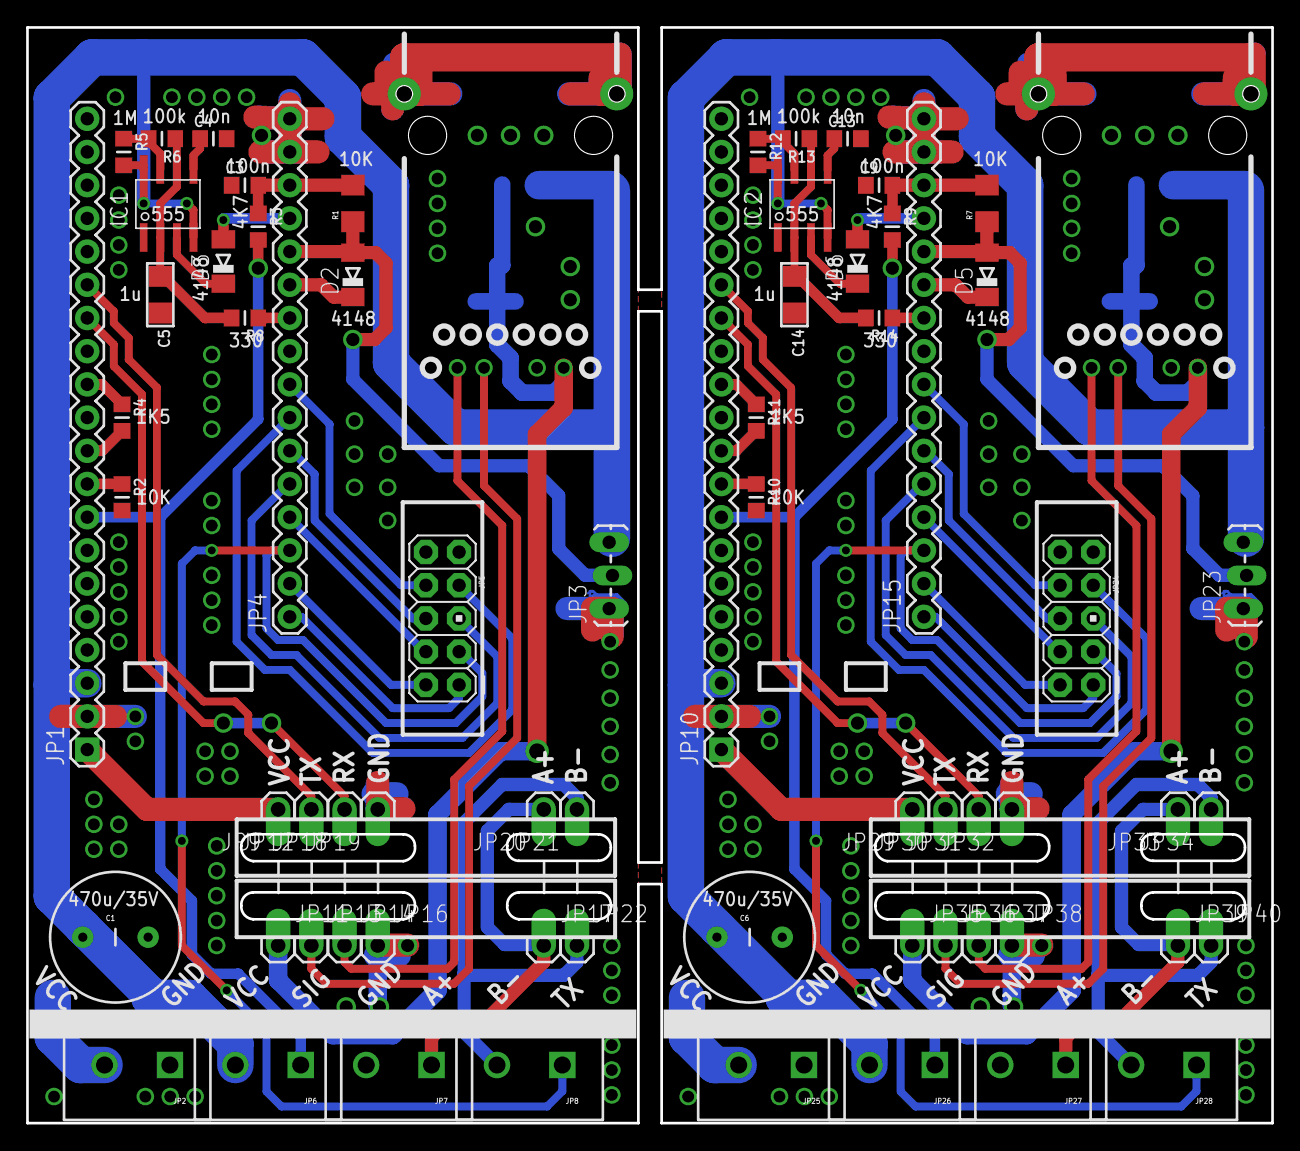
[picture p25: board AQETHBluePill_w_RESET_MOD4ELECROW.brd from above]

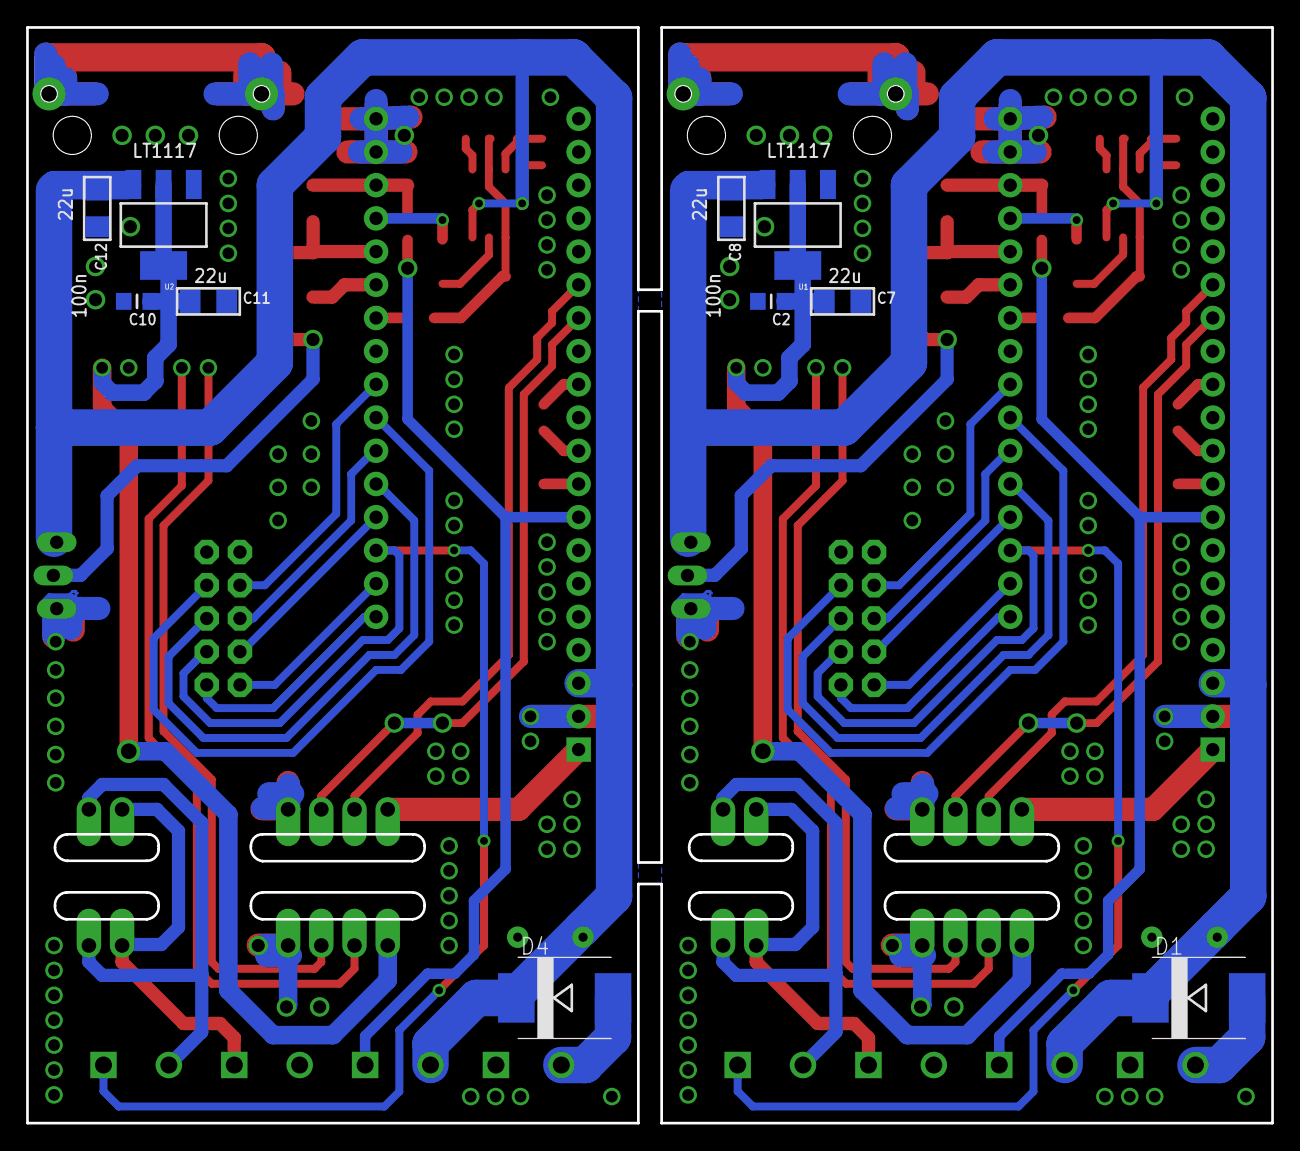
[picture p26: board AQETHBluePill_w_RESET_MOD4ELECROW.brd from below]

Board: 2 copper layers, 95.2 x 83.8 mm, 78 parts (10 on the bottom side), 60 nets.

Parts:
C1, C6: 470uF/35V; CAP-PTH-5MM
C2, C3, C9, C10: 100n; _0805MP
C4, C13: 10n; _0805MP
C5, C14: 1u; 1206
C7, C8, C11, C12: 22u; 1206
D1, D4: SS34; SMC
D2, D3, D5, D6: 1N4148; MINIMELF
IC1, IC2: IC_555-SOIC8; SOIC-8
JP1, JP10: M20; 1X20
JP2, JP6, JP7, JP8, JP25, JP26, JP27, JP28: SCREWTERMINAL-5MM-2
JP3, JP23: 1X03_LOCK_LONGPADS
JP4, JP15: M16PTH; 1X16
JP5, JP24: M05X2PTH; AVR_ICSP
JP9, JP11, JP12, JP13, JP14, JP16, JP17, JP18, JP19, JP20, JP21, JP22, JP29, JP30, JP31, JP32, JP33, JP34, JP35, JP36, JP37, JP38, JP39, JP40: M01OFFSET; 1X01_OFFSET
R1, R7: 10K; 1206
R2, R10: 10K; _0805MP
R3, R9: 4k7; _0805MP
R4, R11: 1K5; _0805MP
R5, R12: 1M; _0805MP
R6, R13: 100K; _0805MP
R8, R14: 330; _0805MP
U1, U2: SOT223

Connections:
3.3V: C3.2, JP4.14, R1.2, R3.1
3.3V1: C9.2, JP15.14, R7.2, R9.1
3V3_SECOND: JP1.1, JP9.1
3V3_SECOND1: JP10.1, JP29.1
5V: C1.1, C8.1, D1.C, IC1.4, IC1.8, JP1.3, JP3.3, JP6.2, R5.2, U1.3
5V1: C6.1, C12.1, D4.C, IC2.4, IC2.8, JP10.3, JP23.3, JP26.2, R12.2, U2.3
+A_1: JP27.1, JP33.1, JP39.1
+A_485: JP7.1, JP17.1, JP20.1
-B_1: JP28.2, JP34.1, JP40.1
-B_485: JP8.2, JP21.1, JP22.1
CTRL: C4.1, IC1.5
CTRL1: C13.1, IC2.5
DS18S20_SIGNAL_PIN: JP1.8, JP6.1, R3.2
DS18S20_SIGNAL_PIN1: JP10.8, JP26.1, R9.2
GND: C1.2, C2.2, C3.1, C4.2, C5.2, C7.2, C8.2, IC1.1, JP1.2, JP2.1, JP3.1, JP4.15, JP4.16, JP5.9, JP5.10, JP7.2, JP16.1, JP19.1, R2.2, U1.1
GND2: C6.2, C9.1, C10.2, C11.2, C12.2, C13.2, C14.2, IC2.1, JP10.2, JP15.15, JP15.16, JP23.1, JP24.9, JP24.10, JP25.1, JP27.2, JP32.1, JP38.1, R10.2, U2.1
HEARTBEAT: JP4.10, R8.1
HEARTBEAT1: JP15.10, R14.1
K1: JP4.1, JP5.1
K2: JP4.2, JP5.2
K3: JP15.1, JP24.1
K3_OR_TX1: JP15.3, JP24.3, JP28.1
K3_OR_TX2: JP4.3, JP5.3, JP8.1
K4: JP4.4, JP5.4
K5: JP4.5, JP5.5
K6: JP4.6, JP5.6
K7: JP4.7, JP5.7
K8: JP4.8, JP5.8
K9: JP15.2, JP24.2
K10: JP15.4, JP24.4
K11: JP15.5, JP24.5
K12: JP15.6, JP24.6
K13: JP15.7, JP24.7
K14: JP15.8, JP24.8
unnamed: JP1.10, R4.2
unnamed: JP1.9, R2.1
unnamed: JP1.12, R4.1
unnamed: JP10.9, R10.1
unnamed: D4.A, JP25.2
unnamed: C5.1, IC1.2, IC1.6, R6.1, R8.2
unnamed: D3.C, IC1.3
unnamed: IC1.7, R5.1, R6.2
unnamed: JP10.10, R11.2
unnamed: JP10.12, R11.1
unnamed: C14.1, IC2.2, IC2.6, R13.1, R14.2
unnamed: D1.A, JP2.2
unnamed: D6.C, IC2.3
unnamed: IC2.7, R12.1, R13.2
PB10_TX1: D5.C, JP15.11
PB10_TX3: D2.C, JP4.11
PB11_RX1: D5.A, JP15.12, JP23.2, R7.1
PB11_RX3: D2.A, JP3.2, JP4.12, R1.1
RESET: D3.A, JP4.13
RESET1: D6.A, JP15.13
RX1: JP1.14, JP18.1
RX2: JP10.14, JP31.1
TX1: JP1.15, JP12.1
TX2: JP10.15, JP30.1
VCC: C2.1, C7.1, JP11.1, U1.2, U1.4
VCC1: C10.1, C11.1, JP35.1, U2.2, U2.4
